julioamerico/blackfin-ip-phone/implementacao/doc/Documento de Requisitos.odt

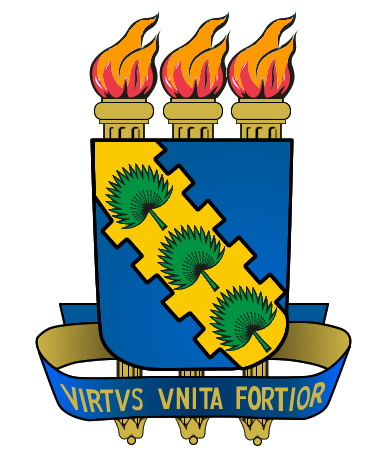
[picture p11: figure]

UNIVERSIDADE FEDERAL DO CEARÁ

CENTRO DE TECNOLOGIA

DEPARTAMENTO DE ENGENHARIA DE TELEINFORMÁTICA

DOCUMENTO DE REQUISITOS

PROJETO: Blackfin IP Phone | DATA: 12/12/2011

# INTRODUÇÃO

O projeto Blackfin IP Phone consiste em um telefone IP com a funcionalidade básica de realizar ligações VoIP. Essa tecnologia compreende um método de comunicação através da fala entre dois locais através de um meio digital de comunicação. A telefonia IP vem sendo abordada há alguns anos o que é motivado pela sua crescente aplicabilidade, bem como a possibilidade de agregação de outras funcionalidades o que a torna um campo de estudo bastante atrativo. A arquitetura de hardware proposta se baseia no processador ADSP-BF518 da família de processadores Blackfin, fabricada pela Analog Devices.

O documento de requisitos se destina a todos os desenvolvedores do projeto Blackfin IP Phone e tem como objetivo principal indicar todos os requisitos funcionais e não-funcionais do projeto, o que auxiliará o seu desenvolvimento através da definição das funcionalidades de hardware, firmware e da aplicação. Este documento é passivo de alterações durante o desenvolvimento, uma vez que poderão ser identificados novos requisitos ou pode ser necessário o detalhamento de alguns requisitos básicos previamente definidos.

# REQUISITOS DO HARDWARE

Esta seção contém todos os requisitos de hardware, com detalhes sobre sua arquitetura, características de processamento, interface com o usuário e descrição dos aspectos mecânicos.

## ARQUITETURA

A arquitetura de hardware é representada através do diagrama de blocos mostrado na Figura 1. Este diagrama de blocos contém as principais interfaces da plataforma de hardware, bem como os barramentos utilizados para comunicação entre os dispositivos e o processador.


Figura 1 - Arquitetura de Hardware

## CARACTERÍSTICAS

Esta seção trata das principais características disponibilizadas pelo hardware, bem como um detalhamento sobre sua capacidade de processamento. De modo geral, o hardware possui as seguintes funcionalidades:

- Memória RAM de 32 MB.
- Memória flash de 4 MB.
- Conexão para cartão de memória microSD.
- Interface de áudio com microfone, speaker e auto-falante.
- Conectividade provida por um módulo WiFi.
- Display LCD gŕafico.
- Botões de navegação e de uso geral.
- Teclado numérico.
- LEDs de uso específico.
- Botão de reset.
- Alimentação a partir de uma bateria de íon de lítio com capacidade de 2000 mAh.

### PROCESSAMENTO

O hardware é baseado no processador ADSP-BF516 da família de processadores Blackfin, do fabricante Analog Devices. Este processador de 32 bits provê os principais barramentos utilizados em aplicações embarcadas, necessários para a interconexão entre dispositivos como LCD, módulo WiFi, memórias e codec de áudio.

### MEMÓRIAS

O processador conta com uma memória SDRAM externa de 32 MB. Para tanto, é utilizada a interface do processador que contém sinais de controle e barramento externo para conexão de memória RAM. A memória SDRAM especificada deve operar a uma frequência de até 133 MHz. Uma memória flash de 4 MB para armazenamento não-volátil é conectada ao processador através de barramento SPI, operando a 100 MHz.

### FONTE

O sistema deve conter uma fonte chaveada de tensão do tipo buck-boost que regulará a tensão proveniente de uma bateria de íon de lítio com capacidade de 2000 mAh, tensão nominal de 3,7 V e dimensões 40 x 65 x 7 mm. A mesma poderá ser recarregada através de um contector micro-USB localizado de modo acessível ao usuário, sem que haja necessidade de abertura do gabinete para seu uso.

## INTERFACE COM O USUÁRIO

A interface com o usuário é contemplada através de botões de navegação, LEDs de uso específico e um display LCD. O gabinete possui características adequadas para essa aplicação, uma vez que provê os rasgos que tornam acessíveis os dispositivos de interface com o usuário. Os conectores de alimentação e de áudio são disponibiveis externamente. Há necessidade de abertura do gabinete somente para a inserção ou remoção do cartão microSD.

O display LCD é do tipo gráfico, com resolução de 160 x 100 pixels, permitindo a visualização de diferentes tipos de tela que permitirão o uso do equipamento para chamada e configuração, por exemplo. Segue abaixo os tipos de tela que o usuário poderá visualizar bem como seu conteúdo.

- Tela de repouso:
  - Data e hora.
  - Nome do telefone (usuário ou empresa).
  - Número do telefone.
  - Quantidade de chamadas perdidas.
- Tela de discagem:
  - Número que está sendo discado.
  - Após o início da chamada, indica que a chamada está em curso.
- Tela de discagem rápida:
  - Lista com um máximo de 10 contatos.
  - Detalhes sobre o contato selecionado.
- Tela de recebimento de chamada:
  - Número do telefone externo.
  - Nome do telefone externo quando o mesmo estiver cadastrado na lista de contatos.
- Tela de estabelecimento de chamada:
  - Após o estabelecimento da chamada discada ou recebida, indica o tempo de chamada.
  - Modo de funcionamento do speaker (on/off).
- Tela de contatos:
  - Lista de contatos cadastrados.
  - Informações do contato selecionado.
- Tela de opções do menu.
  - Histórico de chamadas.
  - Configuração.
  - Informações do sistema.
- Tela de histórico de chamadas:
  - Chamadas efetuadas.
  - Chamadas recebidas.
  - Chamadas perdidas.
- Tela de configuração:
  - Configuração de conta.
    - Nome do telefone (usuário ou empresa).
    - Servidor SIP.
  - Configuração de data e hora.
    - Servidor NTP.
  - Configuração da rede.
    - Habilitação do DHCP (endereço IP dinâmico).
    - Endereço IP.
    - Máscara de rede.
    - Gateway padrão.
    - Tempo de jitter.
  - Configuração da tela de discagem rápida.
  - Configuração de codec de áudio.
    - Lista de codecs suportados.
    - Sequência de prioridade.
- Tela de informações do sistema:
  - Versão do firmware.
  - Atualização de firmware.
  - Teste de conexão com o servidor SIP.
  - Apagar lista de contatos.
  - Restauração da configuração básica do equipamento.

## ASPECTOS MECÂNICOS

O hardware deverá ser encapsulado em um gabinete com dimensões aproximadas 70 x 185 x 25 mm. Este gabinete deverá ter rasgos e furos compatíveis com a aplicação, tornando acessíveis todos os botões, LEDs, display LCD e conectores de alimentação e áudio. Este gabinete deverá ter espaço específico para a acomodação da bateria e um mecanismo adequado para o encaixe das partes que o constituem. Seus encaixes devem proporcionar uma fácil abertura, o que permitirá o acesso ao conector do cartão de memória microSD.

# REQUISITOS DE FIRMWARE

Esta seção contém o conjunto de funcionalidades e características que devem ser promovidas pelo firmware bem como informações sobre os projetos de referência, cujas características foram considerados para definição dos requisitos do projeto Blackfin IP Phone.

## PROJETOS DE REFERÊNCIA

Os projetos de referência são aqueles que farão parte do projeto de modo parcial, provendo módulos já definidos, testados e largamente utilizados em aplicações de mesma natureza. Os projetos de referência utilizados são o U-Boot, o uClinux e o Linphone, que representam um bootloader, um sistema operacional para sistemas embarcados e um projeto de telefone IP, respectivamente, portados para sistemas baseados em processadores Blackfin.

### U-Boot

O bootloader utilizado é o U-Boot, versão 2010r1, disponível no portal Blackfin Koop através do projeto Das U-Boot for the Blackfin Processor. Dentre os diversos processadores suportados por esse bootloader encontra-se o Blackfin.

### uClinux

O uClinux é uma distribuição Linux adaptada para sistemas embarcados. Desse modo, suas bibliotecas são menores e as chamadas ao sistema são semelhantes as do Linux, provendo um sistema estável, confiável e com escalabilidade adequada para sistemas embarcados. Além disso, há um suporte ativo e dinâmico dos projetos envolvendo essa distribuição, fomentado e disponibilizado pelo fabricante Analog Devices no portal Blackfin Koop (blackfin.uclinux.org).

### LINPHONE

O Linphne é o projeto de um telefone IP que foi portado para o uClinux e pode ser executado em plataformas baseadas em processadores da família Blackfin.

## APLICAÇÃO DO PROJETO BLACKFIN IP PHONE

Uma parte dos requisitos da aplicação é baseada nos requisitos dos projetos de referência, o que é determinado pela possibilidade de reuso, reduzindo significativamente o esforço e tempo de projeto. Desse modo, os requisitos elicitados nesta seção consideram arquiteturas, funcionalidades e modos de implementação do uClinux e do projeto Linphone.

Considerando as sete camadas do modelo OSI a estrutura de comunicação entre os clientes é semelhante a representada na Tabela 1.

Tabela 1 – Camadas da estrutura de comunicação

CAMADAS DO MODELO OSI | CAMADAS DA ESTRUTURA DE COMUNICAÇÃO
Camada Física | Wi-Fi
Camada de Enlace | IEEE 802.11
Camada de Rede | Internet
Camada de Transporte | UDP
Camada de Sessão | SIP, RTP
Camada de Apresentação | G.711, G.722, G.723, G.726, G.729, Speex
Camada de Aplicação | Aplicação do Projeto Blackfin IP Phone

Esta seção contém os requisitos de firmware relacionados a aplicação, onde são definidos, dentre outros, os protocolos que deverão ser suportados para estabelecimento da conexão com o servidor, os métodos de codificação e decodificação do áudio e as características de armazenamento de dados. Assim, nesta seção serão apresentadas as principais protocolos e padrões suportados, funcionalidades e requisitos de firmware do projeto.

### CODECS DE ÁUDIO

Os codecs de áudio são padrões de codificação e decodificação do sinal de áudio. Sua função é transformar o sinal de áudio analógico em informação digital que irá trafegar na rede, e vice-versa. Para permitir a compatibilidade de codecs entre os usuários em uma aplicação VoIP, é necessário que seja feito uma lista de prioridade de codecs, a partir da qual haverá a checagem de compatilidade com o usuário destino. Caso nenhum dos codecs da lista de prioridades seja aceito pelo usuário destino, então a chamada não será estabelecida. Os codecs de áudio suportados devem ser os mesmos utilizados no projeto Linphone. São eles:

- G.711
- G.722
- G.723
- G.726
- G.729
- Speex

### CONFIGURAÇÃO DE REDE

Em todos os cenários de funcionamento do equipamento deverá ser verificado o gerenciamento da comunicação entre os dispositivos através de um servidor SIP. A seguir são detalhados os modos de aquisição de parâmetros de rede (endereço IP, máscara de rede, gateway) a partir dos quais o servidor estabelecerá a comunicação entre usuários.

#### 4.2.2.1. SERVIDOR SIP

O protocolo de controle de sessão a ser utilizado é o SIP. Este protocolo será utilizado para configuração das sessões através da rede, estabelecendo a localização dos clientes, inicialização e término de sessões.

O usuário deverá ser capaz de registrar o servidor SIP a partir do qual as chamadas serão gerenciadas. Para tanto, o usuário deverá declarar o endereço IP do servidor e a porta utilizada.

#### 4.2.2.2. SERVIDOR DHCP

Quando conectado a um servidor DHCP, os parâmetros de rede serão atribuídos ao equipamento de forma dinâmica. Desse modo, quando o usuário habilitar a conexão do equipamento a um servidor DHCP não deverá ser possível fazer a configuração dos parâmetros de rede manualmente.

### ARMAZENAMENTO DE INFORMAÇÕES

O sistema deverá ser capaz de armazenar informações em sua memória. O espaço alocado para o armazenamento deverá ser definido em tempo de projeto. A Tabela 2 indica os tipos de informações que devem ser armazenadas e seus respectivos dispositivos de armazenamento.

Tabela 2 – Informações a serem armazenadas

TIPO DE INFORMAÇÃO | DISPOSITIVO DE ARMAZENAMENTO
Lista de contatos | Cartão de memória microSD
Lista de discagem rápida | Cartão de memória microSD
Histórico de chamadas | Cartão de memória microSD
Informações do equipamento | Memória flash
Configuração atual do equipamento | Memória flash
Configuração de restauração do equipamento | Memória flash

### CONFIGURAÇÃO DE DATA E HORA

A definição de data e hora deverá ser feita somente de modo automático através da configuração de um servidor NTP. Portanto, o usuário deverá ser capaz de inserir o endereço do servidor NTP responsável pelo ajuste de tempo do equipamento.

A configuração do servidor NTP é opcional. Caso esta configuração não seja realizada, o equipmanento não apresentará informações de data e hora. Caso a conexão entre o equipamento e um servidor DHCP esteja habilitada, a solicitação do endereço do servidor NTP pode ser feita de modo automático. Caso o servidor DHCP responda a esta solicitação, então os parâmetros do servidor NTP deverão ser sobrescritos.

### ATUALIZAÇÃO DO FIRMWARE

Deve ser disponibilizada uma opção de atualização de firmware do equipamento. Esse tipo de atualização tem por objetivo corrigir erros de implementação, agregar ou melhorar as funcionalidades do equipamento.

A atualização de firmware se dá pelo download de uma nova imagem do firmware através de um servidor TFTP. Para tanto, o usuário deverá ser capaz de inserir o endereço do servidor TFTP para as operações de atualização do sistema.

A configuração do servidor TFTP é opcional. Caso esta configuração não seja realizada, o equipmanento não estará habilitado a fazer atualizações de firmware. Caso a conexão entre o equipamento e um servidor DHCP esteja habilitada, a solicitação do endereço do servidor TFTP pode ser feita de modo automático. Caso o servidor DHCP responda a esta solicitação, os parâmetros do servidor TFTP deverão ser sobrescritos.

### RESTAURAÇÃO DO SISTEMA

Na tela de informações do sistema deve haver uma opção para restauração do sistema, onde valores padrão para as configurações são atribuídos, sobrescrevendo os valores atuais. Dentre as informações gravadas nos dispositivos de armazenamento, somente aquelas relacionadas a configuração atual do equipamento deverão ser alteradas. Portanto, informações como lista de contatos, lista de discagem rápida, perfil de configuração de restauração, histórico de chamadas e informações do equipamento não deverão ser apagadas.

# AMBIENTE DE DESENVOLVIMENTO

Esta seção contém todos os detalhes relacionados a configuração das estações de trabalho, softwares e ferramentas utilizadas no desenvolvimento do projeto.

## ESTAÇÕES DE TRABALHO

O desenvolvimento de firmware deve ser realizado em sua totalidade em ambiente Linux, distribuição Ubuntu, versão do Kernel 2.6.35. O desenvolvimento de hardware deverá ser realizado utilizando o sistema operacional Windows 7.

## FERRAMENTAS DE DESENVOLVIMENTO DO FIRMWARE

As ferramentas de desenvolvimento do firmware encontram-se encapsuladas em um módulo dependente da plataforma alvo e denotado por toolchain. O toolchain do Blackfin consiste de um conjunto de utilitários necessários para a compilação, depuração e geração de programas executáveis a partir do código fonte dos artefatos de firmware como bootloader e kernel do uClinux, por exemplo. O toolchain utilizado é disponibilizado pelo potal Blackfin Koop. Para download e instalação do toolchain, ver o Relatório de Firmware.

## FERRAMENTAS DE DESENVOLVIMENTO DO HARDWARE

O desenvolvimento dos esquemas elétricos e layout do projeto Blackfin IP Phone deve ser realizado utilizando o software Altium Designer 10, uma ferramenta EDA (Electronic Design Automation) utilizada para realizar o projeto elétrico e mecânico de equipamentos eletrônicos. Esse software provê de modo centralizado todas as ferramentas necessárias para o desenvolvimento do hardware até a sua efetiva fabricação.
