julioamerico/blackfin-ip-phone/pesquisa/bateria/Li-Polymer_battery_quotation_-_3.7V_2000mAh.xls

 |  | HOLY TECHNOLOGY CO.,LTD
 |  | Address: Room 301, Buliding 2,Lane 5,Bantian Dongcun, Longgang District, Shen Zhen ,China,518129
 |  | Mobile:13652391374 E-mail: info@holyrich.com
Quotation Sheet
Attn: |  | Rômulo Mendes
Date: |  | 24th,September, 2011
Subject: |  | Li-Polymer PC-714065 3.7V 2000mAh battery
 |  |  |  |  | Unit price (USD/pc)
Model | Type | Dimension (mm) | Weight (g) | Discription |  | 5pcs | 1000pcs
PC-714065 | Li-ion | 7.1*40*65mm | About 38g | Li-Polymer battery PL714065, 3.7V 2000mAh cell |  | 3.51 | 3.05
Remark:
1.Price Term: FOB Shenzhen
2.Payment: 100% by T/T transfer to our bank account for order confirmation, balance before shipment;
3.Lead time: 3-4 weeks after order confirmation;
4.Warranty:one year for sale after;
5.The above price will be valid within 60 days, and it is based on the above data in the table, for the special items, the price will be quotated sperately,
