julioamerico/blackfin-ip-phone/implementacao/hw/bom/ip_phone.xls

 | Lista de Materiais
 | Universidade Federal do Ceará |  | Projeto: | Blackfin IP Phone | 1 Placa ($): | 164.84
 | Centro de Tecnologia |  | Documento gerado em: | 2012-01-24 | 1000 Placas ($) | 112.85
 | Dep. de Engenharia de Teleinformática |  |  |  | Itens por Placa | 324
# | Part# | Comment | Footprint | Manufacturer | Designator | eVendorPart# | Quantity | MSRP | Total MSRP | eVendor | eVendorPrice | Total Vendor | MOQ
1 | ANT040015CCS2442MA1 | Chip_Antenna_2.4GHz | ANTENNA | TDK | ANT500 | 445-6134-1-ND | 1 | 3,15 | 3.15 | Digikey | 5,94 | 5.94 | 1000
2 | PC-714065 | Battery |  | HOLY TECHNOLOGY | B600 | PC-714065 | 1 | 3,05 | 3.05 | HOLY TECHNOLOGY | 3,51 | 3.51 | 1000
3 | C1005X7R1C103KT | 10nF | CC1005-0402 | TDK | C100, C102, C103, C104, C105, C106, C107, C108, C509, C619, C620, C621, C622, C623, C624, C629, C630, C631, C632, C633, C634, C642, C643, C644, C645, C646, C647, C648 | 810-C1005X7R1C103K | 28 | 0,004 | 0.11 | Mouser | 0,03 | 0.84 | 1000
4 | CC0402KRX7R9BB221 | 220pF | CC1005-0402 | Yageo | C101, C309 | 311-1035-1-ND | 2 | 0,00335 | 0.01 | Digikey | 0,015 | 0.03 | 1000
5 | GRM1555C1H220JZ01D | 22pF | CC1005-0402 | Murata Electronics North America | C109, C110 | 490-1283-1-ND | 2 | 0,00614 | 0.01 | Digikey | 0,028 | 0.06 | 1000
6 | C1005X7R1C104KT | 100nF | CC1005-0402 | TDK | C200, C201, C202, C300, C314, C315, C405, C501, C503, C504, C507, C508, C603, C611, C615, C616, C617, C618, C627, C628, C638, C639, C640, C641, C650, C653, C654, C655, C656 | 810-C1005X7R1C104K | 29 | 0,005 | 0.14 | Mouser | 0,03 | 0.87 | 1000
7 | CC0402KRX7R6BB473 | 47nF | CC1005-0402 | Yageo | C301 | 311-1334-1-ND | 1 | 0,00429 | 0.00429 | Digikey | 0,02 | 0.02 | 1000
8 | CC0402KRX7R7BB102 | 1nF | CC1005-0402 | Yageo | C302 | 311-1352-1-ND | 1 | 0,00335 | 0.00335 | Digikey | 0,015 | 0.01 | 1000
9 | VE-100M0JTR-0305 | 10uF | VE-100M0JTR-0305 | Lelon | C303 | 140-VE100M0JTR0305 | 1 | 0,099 | 0.10 | Mouser | 0,18 | 0.18 | 1000
10 | C1005X5R0J475MT | 4,7uF | CC1005-0402 | TDK | C304, C307, C310, C311, C312, C313, C500, C502 | 810-C1005X5R0J475M | 8 | 0,108 | 0.86 | Mouser | 0,22 | 1.76 | 1000
11 | GRM155R60J105ME19D | 1uF | CC1005-0402 | Murata Electronics North America | C305, C306, C400, C401, C402, C403, C404, C610, C649, C651 | 490-1319-1-ND | 10 | 0,01193 | 0.12 | Digikey | 0,055 | 0.55 | 1000
12 | T491D227K006AT | 220uF |  | Kemet | C308 | 80-T491D227K006 | 1 | 0,44 | 0.44 | Mouser | 1,28 | 1.28 | 1000
13 | C1005C0G1H121JT | 120pF | CC1005-0402_NP | TDK | C505 | 810-C1005C0G1H121J | 1 | 0,007 | 0.01 | Mouser | 0,03 | 0.03 | 1000
14 | GRM1535C1HR30BDD5D | 0,3pF | CC1005-0402 | Murata | C506 | 81-GRM1535C1HR30BD5D | 1 | 0,012 | 0.01 | Mouser | 0,15 | 0.15 | 1000
15 | C2012Y5V1A106ZT | 10uF | CC1608-0603 | TDK | C600, C601, C602, C604, C605, C613, C614, C625, C626, C635, C636, C637, C652 | 810-C2012Y5V1A106Z | 13 | 0,033 | 0.43 | Mouser | 0,14 | 1.82 | 1000
16 | GRM188F51A225ZE01D | 2,2uF | CC1608-0603 | Murata | C612 | 81-GRM188F51A225ZE01 | 1 | 0,04 | 0.04 | Mouser | 0,17 | 0.17 | 1000
17 | 045138008010890+ | MicroSD | MICRO_SD | AVX Corporation | CON200 | 478-4965-1-ND | 1 | 2,394 | 2.39 | Digikey | 3,86 | 3.86 | 1000
18 | SJ1-2535-SMT | Phone_Jack | Phone_Jack | CUI Inc | CON300, CON301 | CP1-2535SJCT-ND | 2 | 0,415 | 0.83 | Digikey | 0,75 | 1.50 | 1000
19 | IL-Z-C3-A-1-15000 | Crimp |  | JAE Electronics | CR300, CR301, CR302, CR303, CR304, CR305 | 656-ILZC3A115000 | 6 | 0,049 | 0.29 | Mouser | 0,05 | 0.30 | 1000
20 | APT1608SURCK | RED | LED_0603 | Kingbright | D200 | 604-APT1608SURCK | 1 | 0,06 | 0.06 | Mouser | 0,16 | 0.16 | 1000
21 | TLHR4205 | RED | LED 3MM VERMELHO PF-D3 | Vishay Semiconductors | D201, D600 | 78-TLHR4205 | 2 | 0,065 | 0.13 | Mouser | 0,11 | 0.22 | 1000
22 | TLHY4205 | YELLOW | LED 3MM AMARELO PF-D3 | Vishay Semiconductors | D202 | 78-TLHY4205 | 1 | 0,082 | 0.08 | Mouser | 0,13 | 0.13 | 1000
23 | TLHG4205 | GREEN | LED 3MM VERDE PF-D3 | Vishay Semiconductors | D203 | 78-TLHG4205 | 1 | 0,064 | 0.06 | Mouser | 0,10 | 0.10 | 1000
24 | SAM8218-ND | Flat Cable |  | Samtec | FC200 | SAM8218-ND | 1 | 6,20 | 6.20 | Digikey | 10,76 | 10.76 | 1000
25 | GRPB052VWQS-RC | CONN HEADER | CON_JTAG | Sullins | J200 | S9012E-05-ND | 1 | 0,47 | 0.47 | Digikey | 0,95 | 0.95 | 1000
26 | GRPB101VWVN-RC | CONN HEADER | CONECTOR_10_PIN | Sullins Connector Solutions | J201, J202, J302 | S9014E-10-ND | 3 | 0,32775 | 0.98 | Digikey | 0,66 | 1.98 | 1000
27 | IL-Z-2PL-SMTYE | Speaker | CON_IL-Z-2PL | JAE Electronics | J300, J301 | 656-IL-Z-2PL-SMTYE | 2 | 0,22 | 0.44 | Mouser | 0,33 | 0.66 | 1000
28 | 52892-1495 | LCD Connector | LCD_Connector | Molex | J400 | 538-52892-1495 | 1 | 0,45 | 0.45 | Mouser | 1,27 | 1.27 | 1000
29 | 10103594-0001LF | Micro USB B | Micro USB | FCI | J600 | 649-10103594-0001LF | 1 | 0,306 | 0.31 | Mouser | 0,45 | 0.45 | 1000
30 | EXC-3BP600H | FB 60 Ohm @100MHz | INDUTOR_0603 | Panasonic Electronic Components | L300 | 667-EXC-3BP600H | 1 | 0,066 | 0.07 | Mouser | 0,11 | 0.11 | 1000
31 | L-07C3N0SV6T | 3nH | INDUTOR_0402 | Johanson Technology Inc | L500 | 712-1457-1-ND | 1 | 0,225 | 0.23 | Digikey | 0,04 | 0.04 | 1000
32 | VLF4012AT-2R2M1R5 | 2,2uH | POWER INDUCTOR | TDK | L600 | 445-3233-1-ND | 1 | 0,495 | 0.49 | Digikey | 0,77 | 0.77 | 500
33 | BLM18PG300SN1D | Ferrite Bead 30 Ohm | INDUTOR_0603 | Murata | L602 | 81-BLM11P300S | 1 | 0,041 | 0.04 | Mouser | 0,19 | 0.19 | 1000
34 | NHD-C160100DiZ-FSW-FBW | NHD-C160100DiZ-FSW-FBW |  | Newhaven Display | LCD400 | 763-C160100DIZFSWFBW | 1 | 15,39 | 15.39 | Mouser | 18,55 | 18.55 | 50
35 | POM-2738P-C33-R | MIC | CON_IL-Z-2PL | PUI Audio | M300 | 665-POM2738PC33R | 1 | 1,13 | 1.13 | Mouser | 1,98 | 1.98 | 500
36 | IL-Z-2S-S125C3 | Socket Housing |  | JAE Electronics | P300, P301, P302 | 656-IL-Z-2S-S125C3 | 3 | 0,042 | 0.13 | Mouser | 0,11 | 0.33 | 1000
37 | SM02B-SRSS-TB(LF)(SN) | Header 2x1 | HEADER 2X1 | JST Sales America Inc | P400 | 455-1802-1-ND | 1 | 0,23142 | 0.23 | Digikey | 0,38 | 0.38 | 500
38 | S3B-XH-SM4-TB(LF)(SN) | Header 3x1 | HEADER 3x1 | JST Sales America Inc | P600 | 455-2263-1-ND | 1 | 0,5125 | 0.51 | Digikey | 0,67 | 0.67 | 100
39 | CRCW040222R0JNED | 22R | CR1005-0402 | Vishay/Dale | R100, R101, R102, R103, R104, R105, R106, R107, R108, R109, R110, R111, R112, R113, R114, R115, R116, R117, R118, R119, R120, R121, R122, R123, R124, R125, R126, R127, R128, R129, R130, R131, R132, R134, R136, R138, R140, R141, R142, R308, R309, R311, R312, R326 | 71-CRCW0402J-22-E3 | 44 | 0,015 | 0.66 | Mouser | 0,08 | 3.52 | 1000
40 | RC0402JR-0710KL | 10K | CR1005-0402, CR1005-0402_NP | Yageo | R133, R135, R144, R146, R201, R219, R220, R221, R222, R223, R224, R225, R226, R227, R228, R229, R230, R303, R306, R400, R402, R412, R502, R503, R504, R505, R506, R507, R508, R509, R510, R511, R512, R513, R515, R516, R517, R518, R519, R520, R521, R522, R523, R524, R607, R608, R614 | 311-10KJRCT-ND | 47 | 0,00253 | 0.12 | Digikey | 0,012 | 0.56 | 1000
41 | RC0402JR-07100KL | 100K | CR1005-0402 | Yageo | R137, R310, R316 | 311-100KJRCT-ND | 3 | 0,00253 | 0.01 | Digikey | 0,012 | 0.04 | 1000
42 | RC0402JR-0733RL | 33R | CR1005-0402 | Yageo | R139, R237, R238 | 311-33JRCT-ND | 3 | 0,00253 | 0.01 | Digikey | 0,012 | 0.04 | 1000
43 | RC0402JR-0733KL | 33K | CR1005-0402 | Yageo | R143 | 311-33KJRCT-ND | 1 | 0,00253 | 0.00253 | Digikey | 0,012 | 0.01 | 1000
44 | RMCF0402JT10M0 | 10M | CR1005-0402 | Stackpole Electronics Inc | R145 | RMCF0402JT10M0CT-ND | 1 | 0,00256 | 0.00256 | Digikey | 0,02 | 0.02 | 1000
45 | CR0603-JW-101GLF | 100R | CR1608-0603 | Bourns | R200, R210, R211, R212, R602 | 652-CR0603-JW-101GLF | 5 | 0,01 | 0.05 | Mouser | 0,06 | 0.30 | 1000
46 | ERJ-2GE0R00X | 0R | CR1005-0402 | Panasonic Electronic Components | R202, R204, R205, R208, R209, R215, R218, R231, R232, R233, R234, R235, R236, R313, R317, R319, R320, R321, R322, R323, R324, R325, R327, R328, R329, R330, R331, R332, R333, R401, R403, R404, R405, R406, R407, R408, R409, R410, R411, R500, R525 | 667-ERJ-2GE0R00X | 41 | 0,004 | 0.16 | Mouser | 0,05 | 2.05 | 1000
47 | RC0402JR-071K2L | 1K2 | CR1005-0402 | Yageo | R206, R207, R314, R606 | 311-1.2KJRCT-ND | 4 | 0,00253 | 0.01 | Digikey | 0,012 | 0.05 | 1000
48 | CRCW040249R9FKED | 49R9 | CR1005-0402_NP | Vishay/Dale | R214, R216, R217 | 71-CRCW0402-49.9-E3 | 3 | 0,015 | 0.04 | Mouser | 0,07 | 0.21 | 1000
49 | RC0402JR-072K2L | 2K2 | CR1005-0402 | Yageo | R304 | 311-2.2KJRCT-ND | 1 | 0,00253 | 0.00253 | Digikey | 0,012 | 0.01 | 1000
50 | RMCF0402FT330K | 330K | CR1005-0402 | Stackpole Electronics Inc | R315 | RMCF0402FT330KCT-ND | 1 | 0,00384 | 0.00384 | Digikey | 0,04 | 0.04 | 1000
51 | RC0402JR-0747KL | 47K | CR1005-0402 | Yageo | R318 | 311-47KJRCT-ND | 1 | 0,00253 | 0.00253 | Digikey | 0,012 | 0.01 | 1000
52 | 304-200K-RC | 200K | CR1005-0402 | Xicon | R501, R514 | 304-200K-RC | 2 | 0,016 | 0.03 | Mouser | 0,04 | 0.08 | 1000
53 | CR0603-JW-152GLF | 1K5 | CR1608-0603 | Bourns | R600 | 52-CR0603-JW-152GLF | 1 | 0,008 | 0.01 | Mouser | 0,02 | 0.02 | 1000
54 | RK73Z2ETTD | 0R | CR3225-1210 | KOA Speer | R601, R611 | 660-RK73Z2ETTD | 2 | 0,08 | 0.16 | Mouser | 0,14 | 0.28 | 1000
55 | CR0603-J/-000ELF | 0R | CR1608-0603 | Bourns | R603, R604, R612 | 652-CR0603-J/-000ELF | 3 | 0,008 | 0.02 | Mouser | 0,02 | 0.06 | 1000
56 | RC0402JR-07680RL | 680R | CR1005-0402 | Yageo | R605 | 311-680JRCT-ND | 1 | 0,00253 | 0.00253 | Digikey | 0,012 | 0.01 | 1000
57 | ERJ-2RKF2052X | 20K5 | CR1005-0402 | Panasonic - ECG | R613 | P20.5KLCT-ND | 1 | 0,00672 | 0.01 | Digikey | 0,06 | 0.06 | 1000
58 | ERJ-2RKF2553X | 255K | CR1005-0402 | Panasonic - ECG | R615 | P255KLCT-ND | 1 | 0,00672 | 0.01 | Digikey | 0,06 | 0.06 | 1000
59 | 254-DS238-RO | 8 Ohms/1W |  | Kobitone | S300 | 254-DS238-RO | 1 | 1,32 | 1.32 | Mouser | 2,25 | 2.25 | 1000
60 | 254-DR132-RO | 32 Ohms/26mW |  | Kobitone | S301 | 254-DR132-RO | 1 | 1,52 | 1.52 | Mouser | 1,98 | 1.98 | 1000
61 | PTS525SM10SMTR LFS | SW | PUSH-PTS525 | C&K Components | SW200, SW201 | 611-PTS525SM10-LFS | 2 | 0,244 | 0.49 | Mouser | 0,48 | 0.96 | 1000
62 | ADSP-BF516KBCZ-4F4 | ADSP-BF516KBCZ-4F4 | BGA168 | Analog Device | U100 | ADSP-BF516KBCZ-4F4 | 1 | 14,15 | 14.15 | Avnet | 19,42 | 19.42 | 500
63 | MT48LC16M16A2BG-75 IT:D | MT48LC16M16A2BG-75 | VFBGA54 | Micron | U101 | MT48LC16M16A2BG-75 IT:D | 1 | 8,33 | 8.33 | Avnet | 9,23 | 9.23 | 100
64 | CAT811STBI-GT3 | CAT811S | SOT-143 | ON Semiconductor | U200 | 698-CAT811STBI-GT3 | 1 | 0,156 | 0.16 | Mouser | 0,22 | 0.22 | 1000
65 | S25FL064P0XNFI000 | S25FL064P0XNFI000 | WSON8 | Spansion | U202 | S25FL064P0XNFI000 | 1 | 1,88 | 1.88 | Avnet | 1,99 | 1.99 | 100
66 | FSA2259UMX | FSA2259 | QFN-10FSA | Fairchild Semiconductor | U300 | 512-FSA2259UMX | 1 | 0,22 | 0.22 | Mouser | 0,68 | 0.68 | 1000
67 | WM8940GEFL/V | WM8940 | QFN24 | Wolfson Microelectronics | U301 | 238-WM8940GEFL/V | 1 | 1,70 | 1.70 | Mouser | 2,82 | 2.82 | 1000
68 | 74LVC1G384GV,125 | 74LVC1G384 | SOT753 | NXP Semiconductors | U302 | 771-LVC1G384GV125 | 1 | 0,046 | 0.05 | Mouser | 0,07 | 0.07 | 1000
69 | ADP5587ACPZ-R7 | ADP5587 | QFN-24 | Analog Devices | U400 | ADP5587ACPZ-R7CT-ND | 1 | 1,725 | 1.73 | Digikey | 3,45 | 3.45 | 1000
70 | NVT2006PW,118 | NVT2006PW118 | TSSOP16 | NXP Semiconductors | U500, U502 | 771-NVT2006PW118 | 2 | 0,375 | 0.75 | Mouser | 0,76 | 1.52 | 1000
71 | 450-0037 | TiWi01-R2 | WIFI_MODULE | LS Research | U501 | 741-450-0037 | 1 | 30,80 | 30.80 | Mouser | 32,55 | 32.55 | 100
72 | TPS63001DRCR | TPS63001DRCR | SON10 | Texas Instruments | U600 | 296-19643-1-ND | 1 | 2,25 | 2.25 | Digikey | 4,5 | 4.50 | 1000
73 | BQ24090DGQT | BQ24090 | MSOP10 | Texas Instruments | U601 | 595-BQ24090DGQT | 1 | 1,16 | 1.16 | Mouser | 2,76 | 2.76 | 1000
74 | AME8800DEETZ | AME8800DEETZ | SOT-23 | AME | U604 | 827-AME8800DEETZ | 1 | 0,171 | 0.17 | Mouser | 0,67 | 0.67 | 1000
75 | NCP1117ST18T3G | NCP1117ST18T3G | SOT223 | ON Semiconductor | U605 | 863-NCP1117ST18T3G | 1 | 0,171 | 0.17 | Mouser | 0,35 | 0.35 | 1000
76 | TPS73601DCQR | TPS73601 | SOT223 - 6P | Texas Instruments | U606 | 595-TPS73601DCQR | 1 | 1,17 | 1.17 | Mouser | 2,25 | 2.25 | 1000
77 | MC-306 32.7680K-A0:ROHS | 32.768KHz | XTAL_32.768kHz | Epson | X100 | 732-MC30632.7680KA0R | 1 | 0,378 | 0.38 | Mouser | 0,95 | 0.95 | 1000
78 | ASFL1-25.000MHZ-EC-T | 25MHz | OSC_25MHz | ABRACON | Y100 | 300-8254-1-ND | 1 | 1,292 | 1.29 | Digikey | 2,55 | 2.55 | 1000
79 | ASEK2-32.768KHz-LRT | 32,768K | OSCILLATOR_32K | Abracon | Y500 | 815-ASEK2-32.7K-LRT | 1 | 2,44 | 2.44 | Mouser | 3,66 | 3.66 | 500
