julioamerico/blackfin-ip-phone/implementacao/hw/prj/ip_phone.pdf

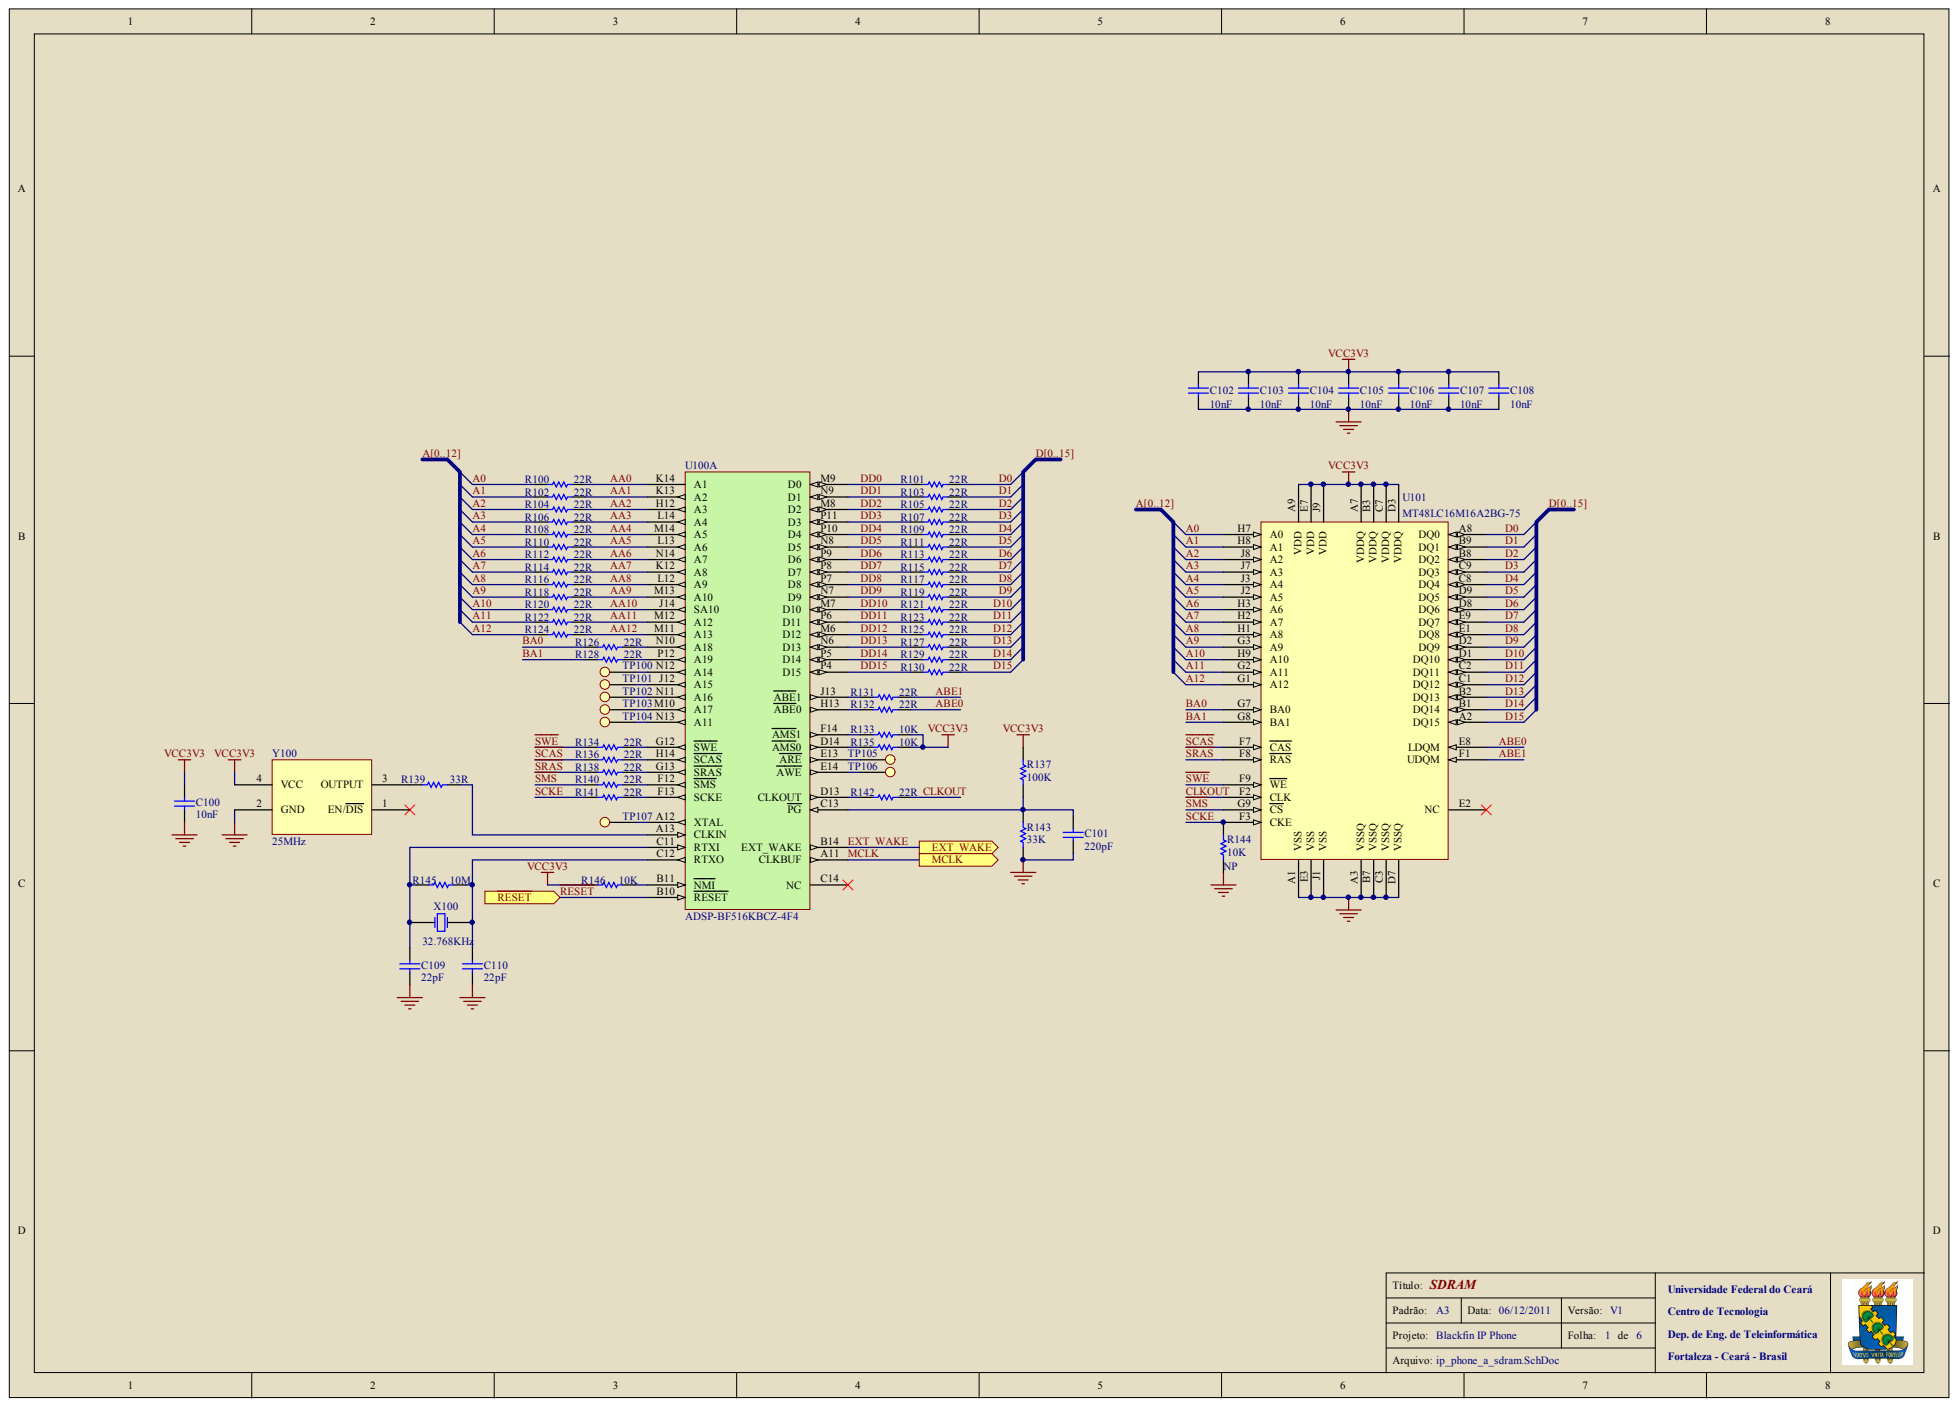
[picture p12: page 1]

SCAS SRAS SMS SCKE

VCC3 V 3

RTXO C12 | 1 MCL K

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

P r oj e t o : Bl a c kfi n I P P h o n e | | F o l h a : d e

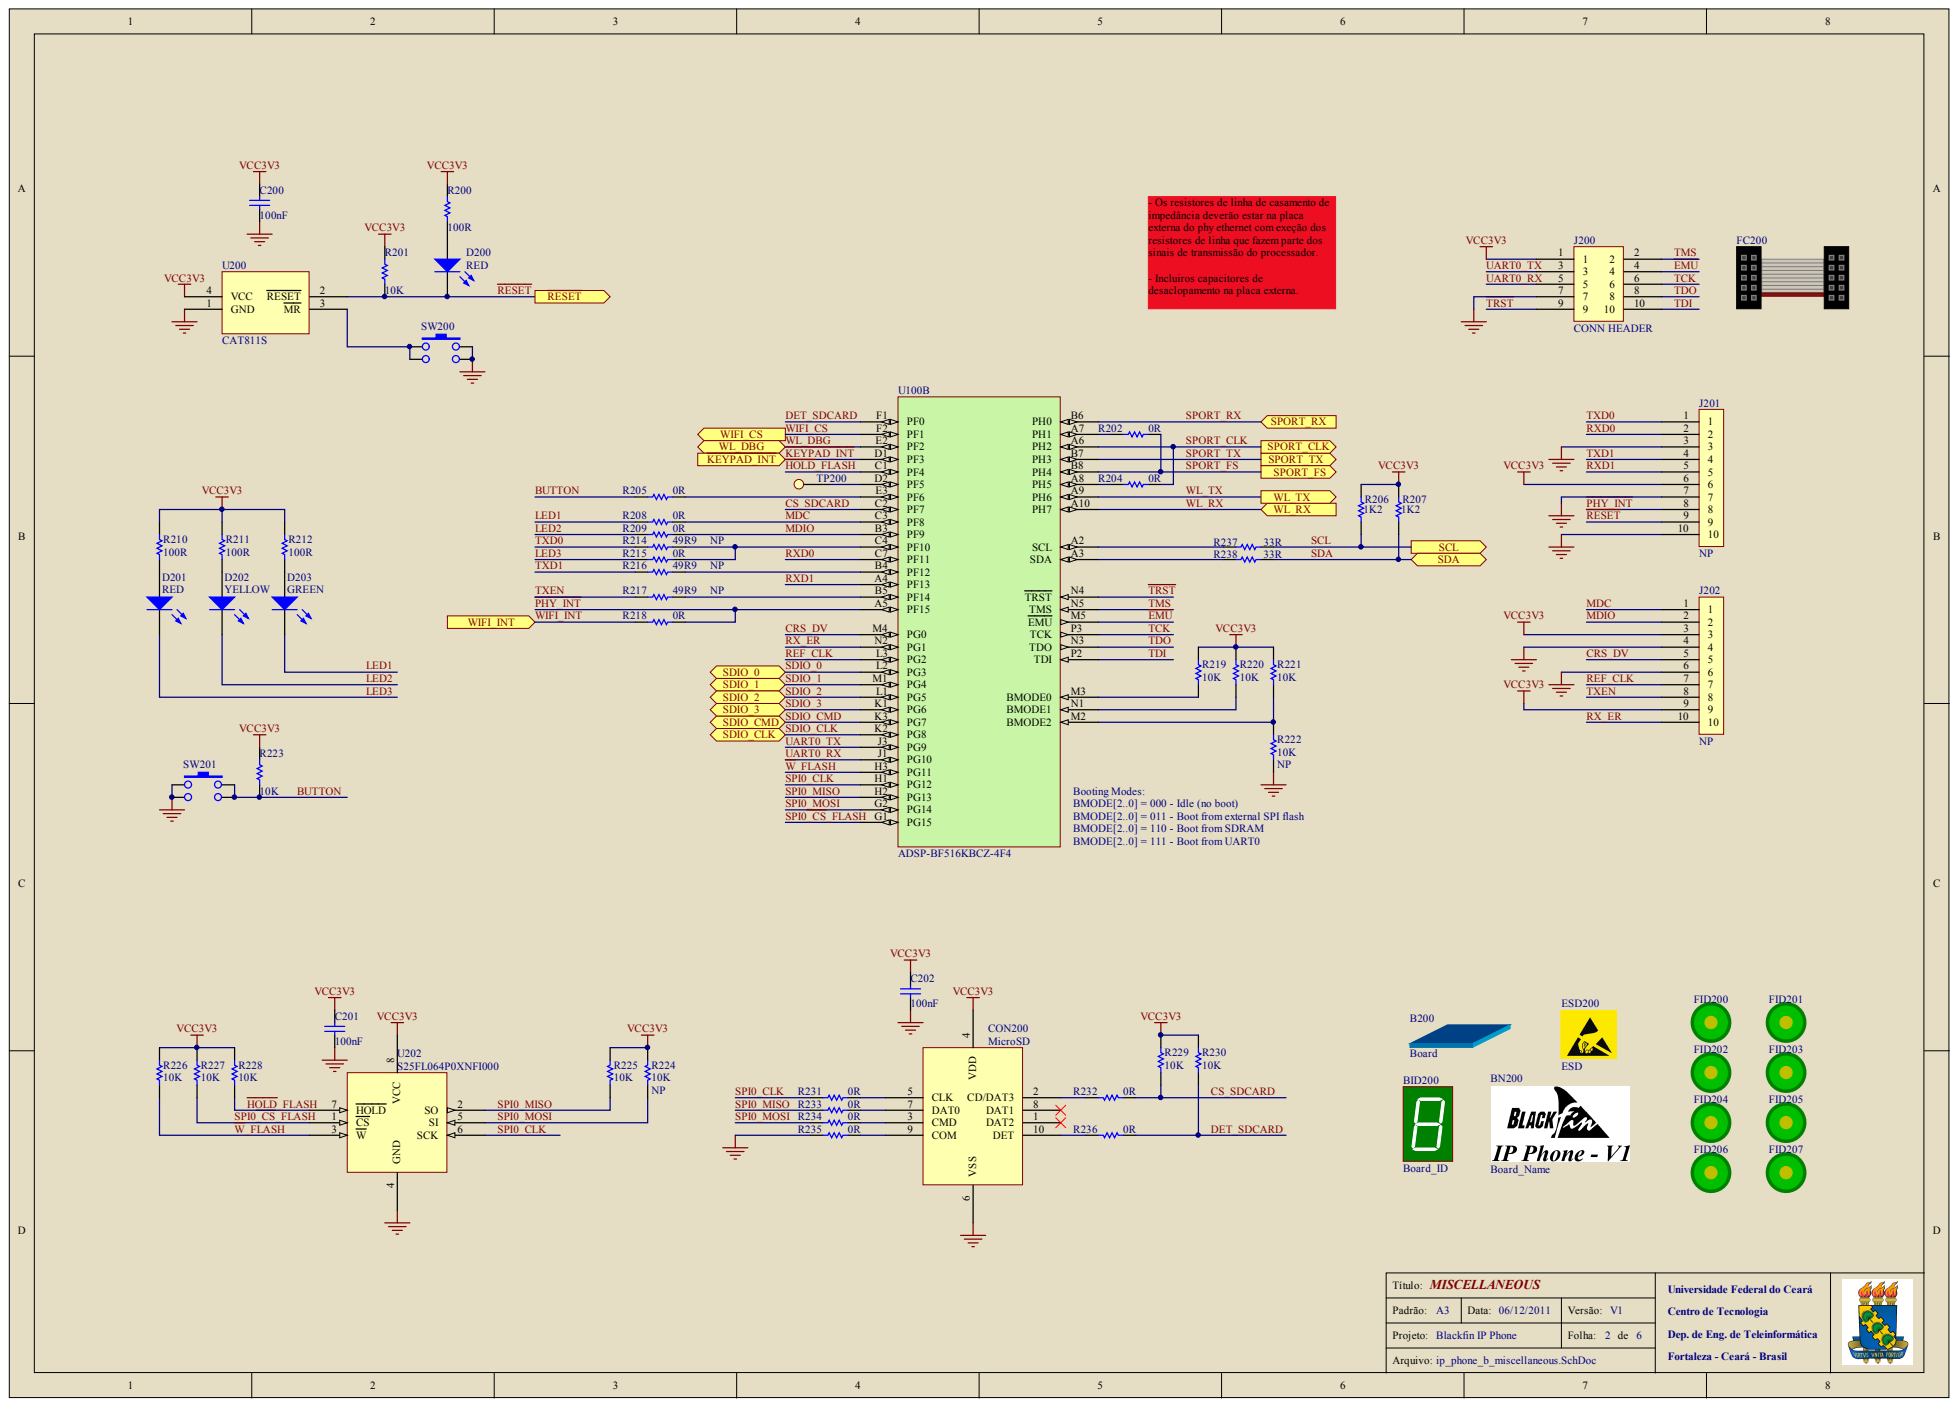
[picture p13: page 2]

- Os resistores de linha de casamento de
impedância deverão estar na placa
externa do phy ethernet com exeção dos
resistores de linha que fazem parte dos
sinais de transmissão do processador.

- Incluiros capacitores de
desaclopamento na placa externa.

Booting Modes:
BMODE[2..0] = 000 - Idle (no boot)
BMODE[2..0] = 011 - Boot from external SPI flash
BMODE[2..0] = 110 - Boot from SDRAM
BMODE[2..0] = 111 - Boot from UART0

Título: MISCELLANEOUS | Universidade Federal do Ceará Centro de Tecnologia Dep. de Eng. de Teleinformática Fortaleza - Ceará - Brasil

Padrão: | Data: 06/12/2011 | Versão: V1

Projeto: Blackfin IP Phone | | Folha: de

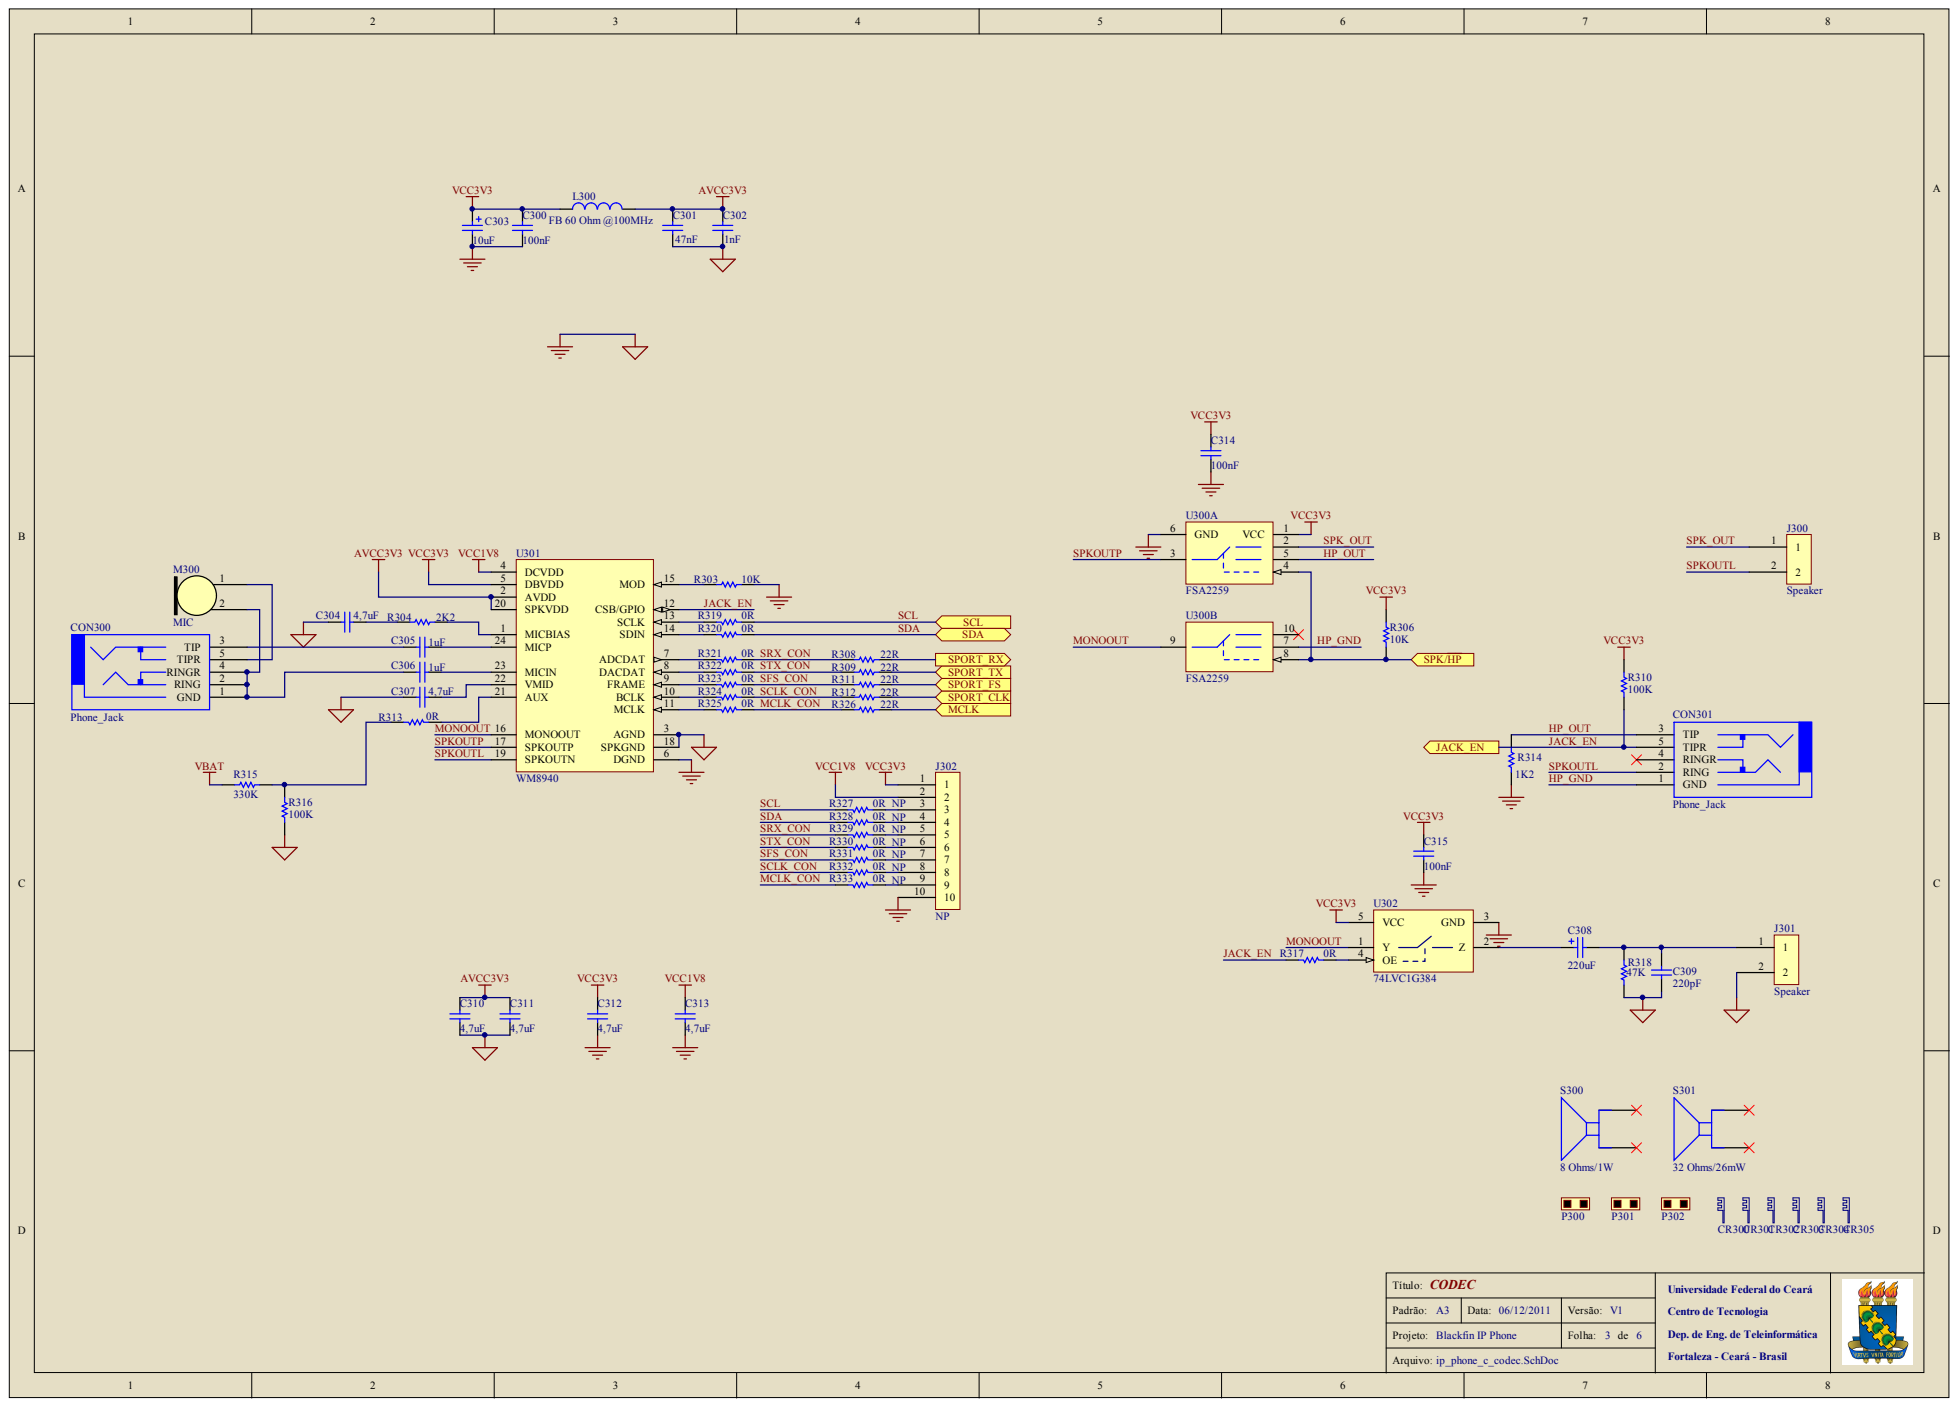
[picture p14: page 3]

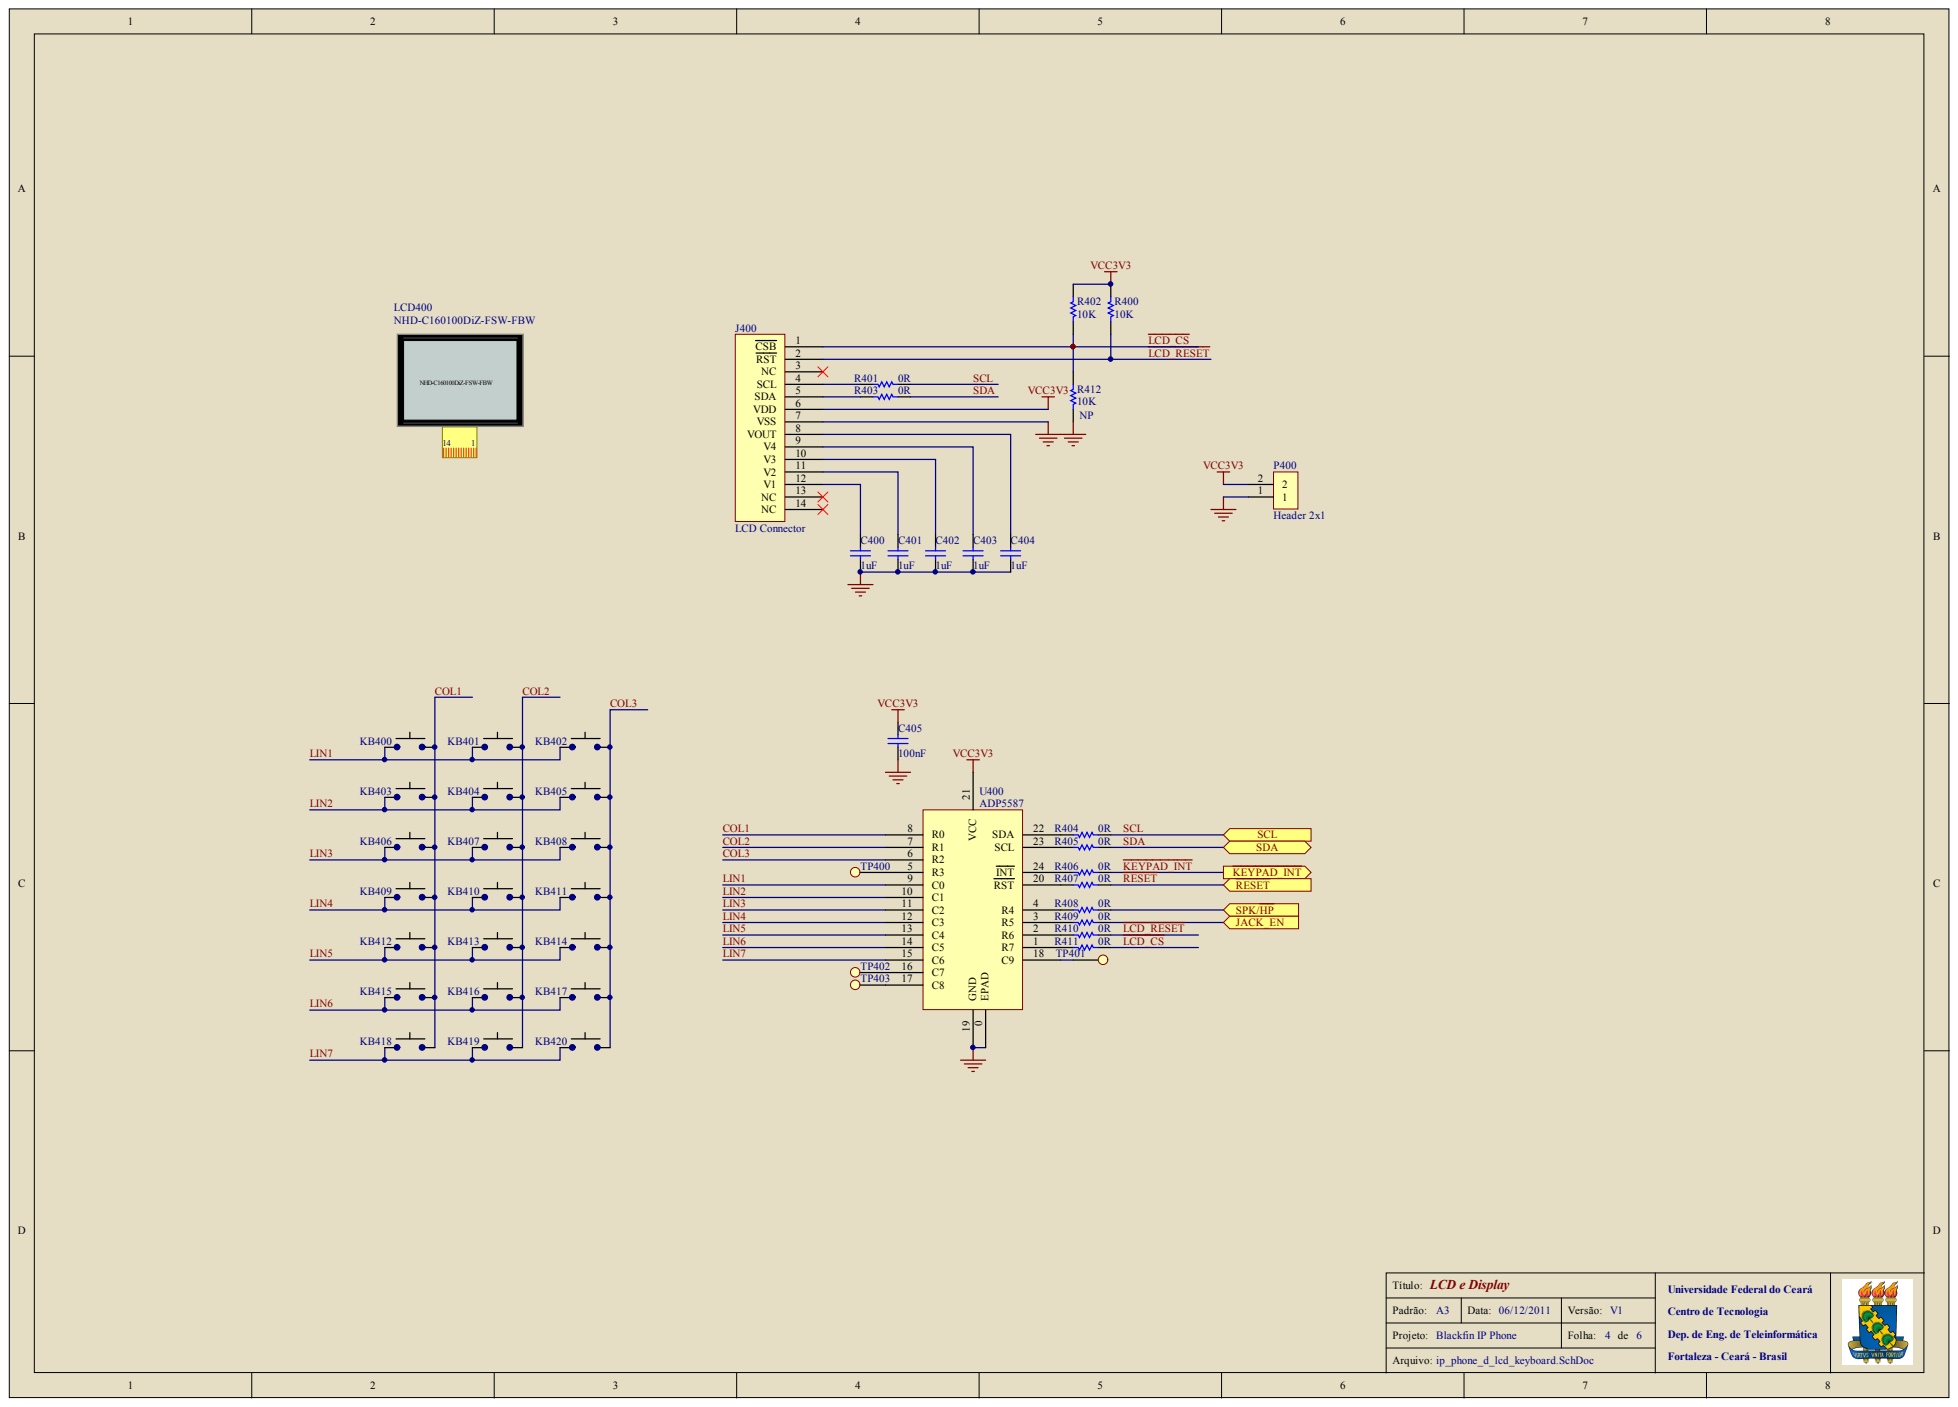
[picture p15: page 4]

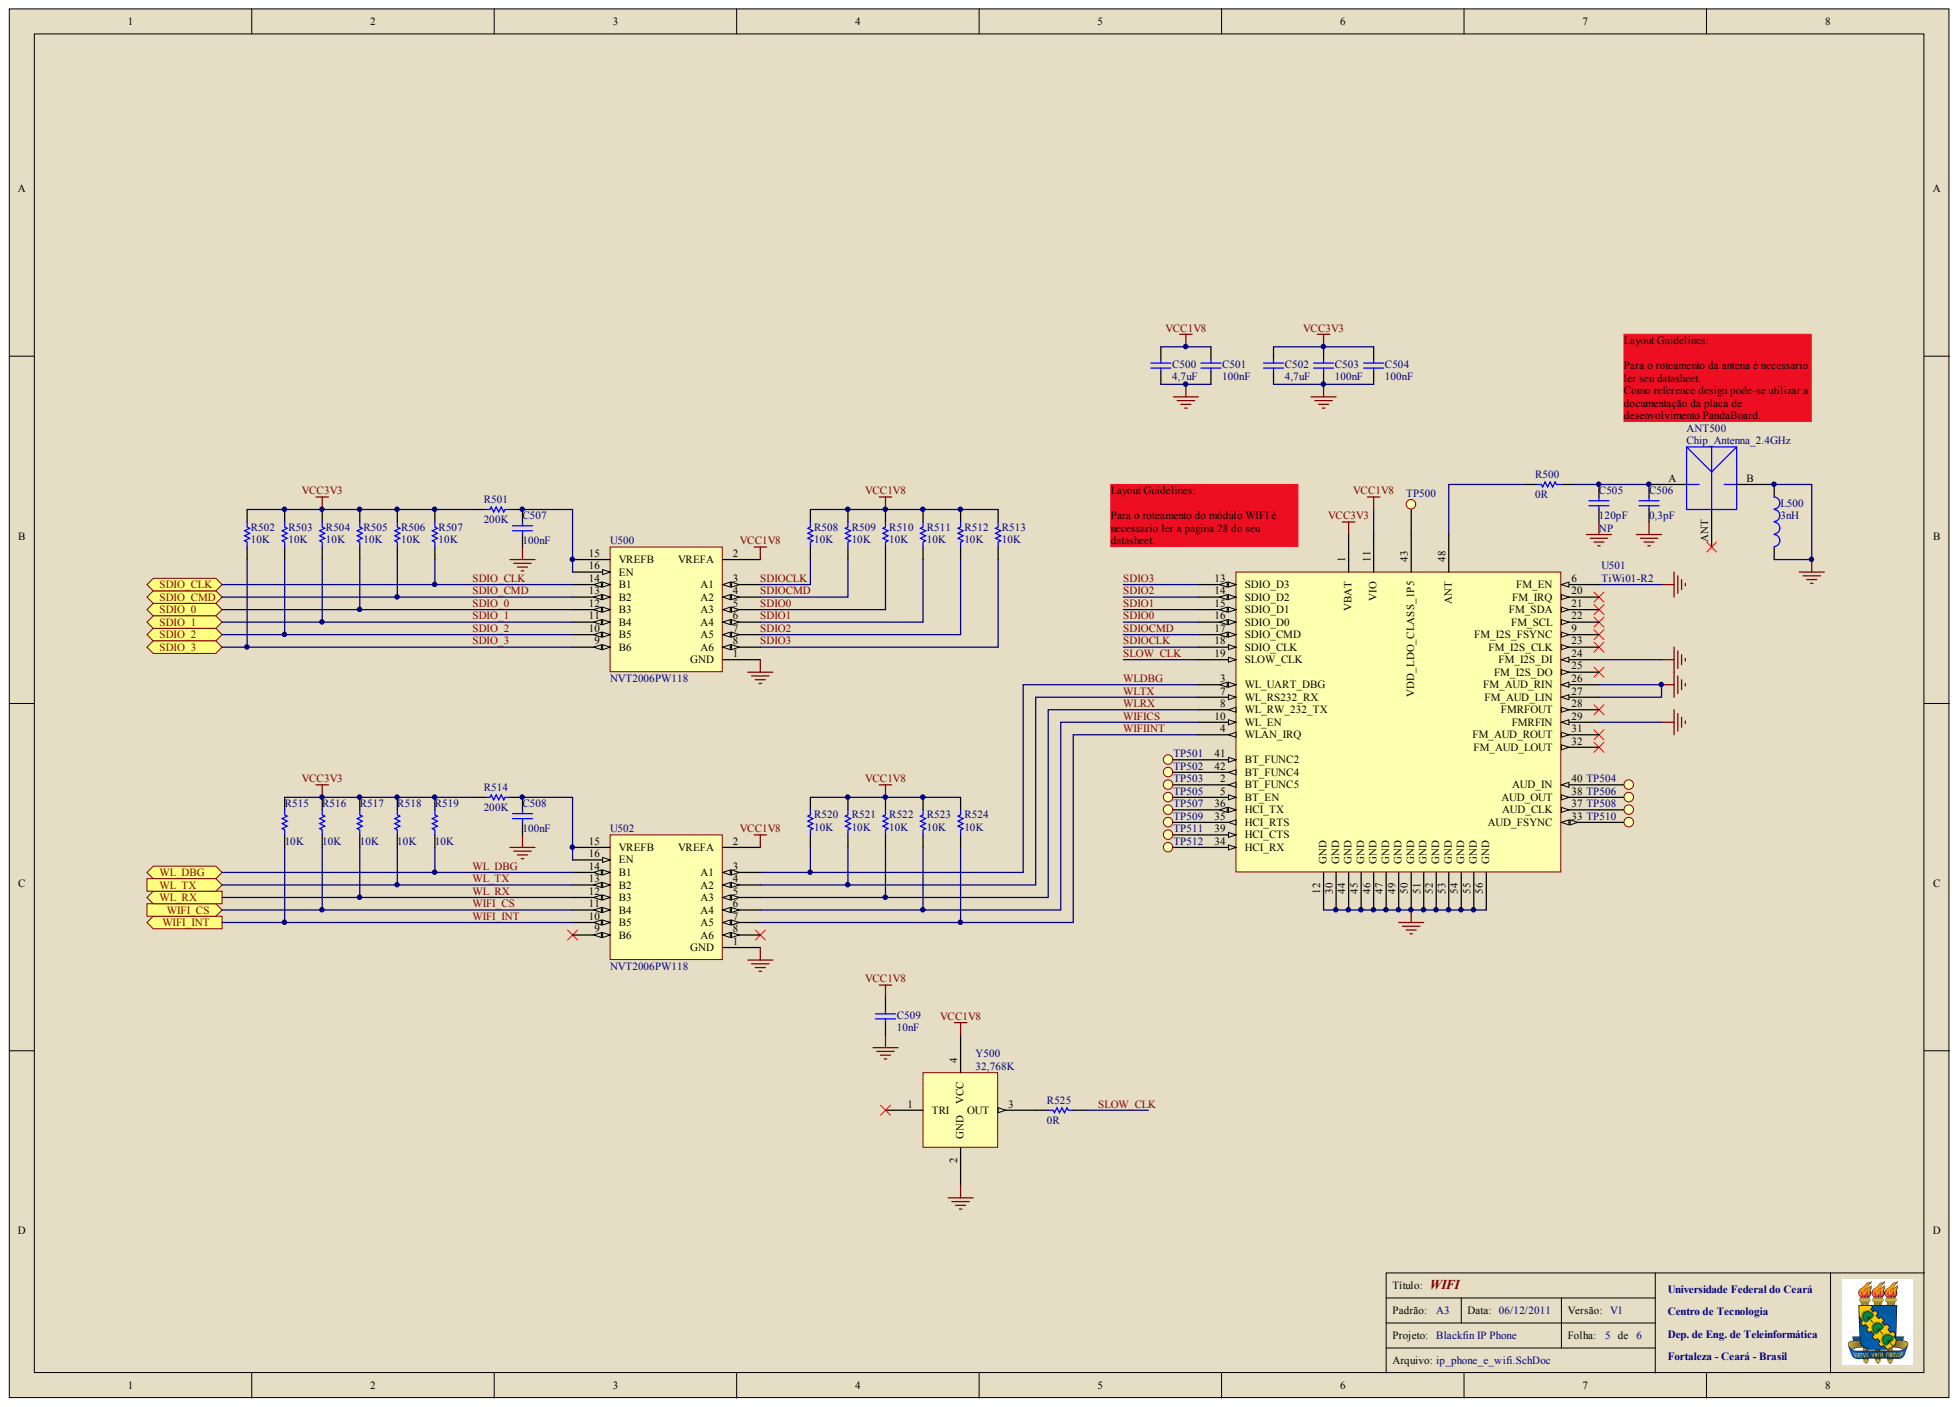
[picture p16: page 5]

Para o roteamento da antena é necessario
ler seu datasheet.
Como reference design pode-se utilizar a
documentação da placa de
desenvolvimento PandaBoard.

Para o roteamento do módulo WIFI é
necessario ler a pagina 28 do seu
datasheet.

WLTX | WL_RS232_RX 7
WLRX | WL_RW_232_TX 8

WIFIINT | WLAN_IRQ 4

TP501 TP502 TP503 TP505 TP507 R524 TP509 10K TP511 TP512 | BT_FUNC2 41 BT_FUNC4 42 BT_FUNC5 2 BT_EN 5 HCI_CTS 39 HCI_RX 34

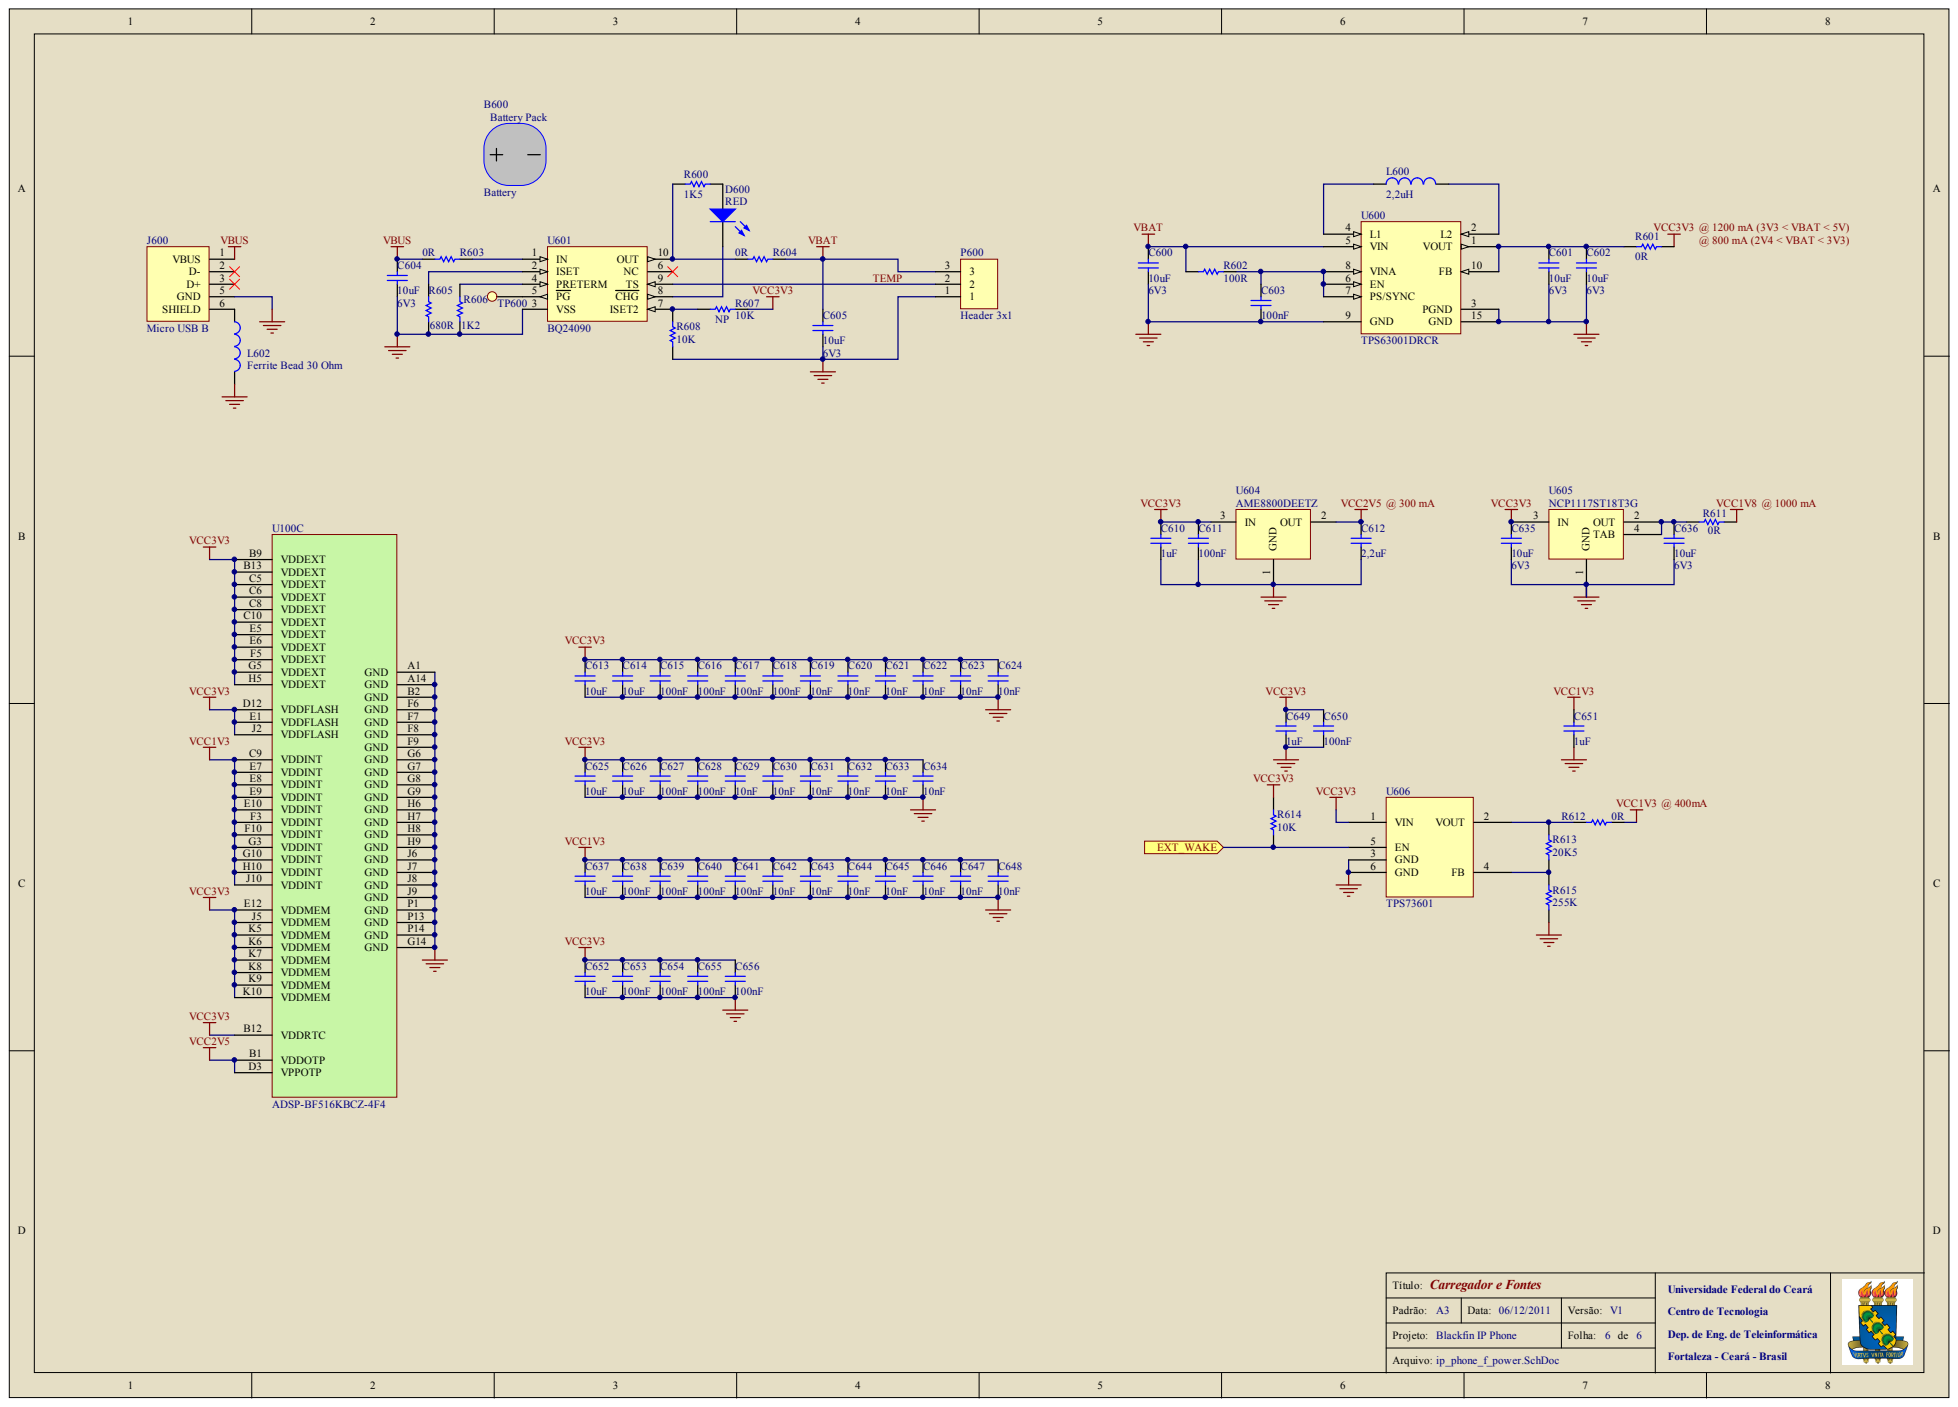
[picture p17: page 6]
