julioamerico/blackfin-ip-phone/(list of files, drawings)

Other design files:
implementacao/extras/pcb/ethernet_ipphone_pcb.PcbDoc
implementacao/extras/prj/ethernet_ipphone_prj.PrjPcb
implementacao/extras/sch/ethernet_ipphone_sch.SchDoc
implementacao/hw/pcb/ip_phone_pcb.PcbDoc
implementacao/hw/prj/ip_phone.PrjPcb
implementacao/hw/sch/ip_phone_a_sdram.SchDoc
implementacao/hw/sch/ip_phone_b_miscellaneous.SchDoc
implementacao/hw/sch/ip_phone_c_codec.SchDoc
implementacao/hw/sch/ip_phone_codec.SchDoc
implementacao/hw/sch/ip_phone_d_lcd_keyboard.SchDoc
implementacao/hw/sch/ip_phone_e_wifi.SchDoc
implementacao/hw/sch/ip_phone_f_power.SchDoc
implementacao/hw/sch/ip_phone_g_codec.SchDoc
