julioamerico/blackfin-ip-phone/(commit log)

2011-07-06 Inseridos os templates de BOM e SCH.
2011-07-18 Criado o projeto.
    [ip_phone.PrjPcb]
2011-07-18 Associadas as bibliotecas ao projeto.
    [ip_phone.PrjPcb]
2011-07-20 inclusao dos footprints da memoria flash, dos resistores, dos capacitores, dos indutores e do processador.
2011-07-20 inclusao das simbologias da memoria flash, dos resistores, dos capacitores, dos indutores e do processador.
2011-07-27 inclusao do footprint do VFBGA54 da SDRAM
2011-08-12 Criado o footprint do codec
2011-08-17 inclusao do footprint CR0402_NP e CR0603_NP na simbologia do resistor
2011-08-17 inclusao dos footprints CR0402_NP e CR0603_NP
2011-08-17 inclusao do arquivo
    [ip_phone_a_sdram.SchDoc]
2011-08-17 inclusao dos esquematicos no projeto
    [ip_phone.PrjPcb]
2011-08-19 inclusao da simbologia do conector de 10 pinos
2011-08-19 inclusao do footprint do conector de 10 pinos
2011-08-22 - Alterada disposição dos pinos do bf518-A - Adicionada simbologia do test point - Adicionada simbologia do ci supervisor (cat811) - Adicionada simbologia do cristal de 32.768KHz - Adicionada simbolo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
2011-08-22 - Adicionado footprint do test point - Adicionado footprint do ci supervisor (cat811) - Adicionado footprint do cristal de 32.768KHz - Adicionado footprint do oscilador de 25MHz
2011-08-22 Iniciado esquemático da sdram
    [ip_phone_a_sdram.SchDoc]
2011-08-22 inclusao do footprint SOIC8
2011-08-22 Adicionado o footprint do push-buttom
2011-08-22 inclusao de parametros no switch
2011-08-22 finalizaçao do esquematico. faltando revisao
    [ip_phone_b_miscellaneous.SchDoc]
2011-08-26 mudança dos sinais do conector que vai para a placa da ethernet
    [ip_phone_b_miscellaneous.SchDoc]
2011-08-26 inclusao dos footprints MSOP, led 0603 e Micro USB
2011-08-26 inclusao das simbologias do led, do carregador e do micro USB.
2011-08-28 atualizado esquemático da sdram
    [ip_phone_a_sdram.SchDoc]
2011-08-28 atualizado esquemático do codec
    [ip_phone_c_codec.SchDoc]
2011-08-29 inclusao do footprint do conector da bateria
2011-08-29 mudança dos resistores de 10k da mouser para os da digikey.
    [ip_phone_b_miscellaneous.SchDoc]
2011-08-30 inclusao dos footprints dos reguladores de 2V5 e 1V3
2011-08-30 inclusao das simbologias dos reguladores de 5V, 2V5 e 1V3.
2011-08-30 adaptaçao nos parametros dos capacitores de 100nF
    [ip_phone_b_miscellaneous.SchDoc]
2011-08-31 inclusao do footprint do modulo wifi
2011-08-31 alteraçao nos parametros do sheet
    [ip_phone_f_power.SchDoc]
2011-09-02 mudanca de MII para RMII e inclusao dos sinais que vao para o WIFI
    [ip_phone_b_miscellaneous.SchDoc]
2011-09-02 inclusao do modelo 3D do modulo wifi e inclusao do footprint do level translator
2011-09-05 inclusao do footprint do micro SD
2011-09-05 inclusao do circuito do micro SD
    [ip_phone_b_miscellaneous.SchDoc]
2011-09-05 finalizado faltando apenas o footprint da antena.
    [ip_phone_e_wifi.SchDoc]
2011-09-05 elaboração do esquemático
    [ip_phone_a_sdram.SchDoc]
2011-09-06 implementação
    [ip_phone_c_codec.SchDoc]
2011-09-06 adicionada simbologia para conector de audio
2011-09-06 inclusao dos footprints do resistor 1210, do oscilador 32K e do regulador de 1V8
2011-09-06 inclusao das simbologias do oscilador de 32K e do regulador de 1V8
2011-09-06 implementaçao da revisao do romulo
    [ip_phone_b_miscellaneous.SchDoc]
2011-09-06 implementacao do circuito do oscilador de 32K
    [ip_phone_e_wifi.SchDoc]
2011-09-06 implementaçao da fonte de 1V8
    [ip_phone_f_power.SchDoc]
2011-09-09 update from libraries para os models dos capacitores
    [ip_phone_d_lcd_keyboard.SchDoc]
2011-09-09 inclusao do footprint da antena na simbologia da antena
2011-09-09 inclusao do footprint da antena
2011-09-09 concluido. faltando apenas as nets dos sheets feito pelo julio.
    [ip_phone_b_miscellaneous.SchDoc]
2011-09-09 finalizado. faltando revisao.
    [ip_phone_e_wifi.SchDoc]
2011-09-11 Integração com os demais sheets
    [ip_phone_b_miscellaneous.SchDoc]
2011-09-11 Finalizado. Restando Revisão
    [ip_phone_a_sdram.SchDoc]
2011-09-11 Ocultado Comment dos Test Points.
    [ip_phone_e_wifi.SchDoc]
2011-09-11 Finalizado. Não revisado
    [ip_phone_c_codec.SchDoc]
2011-09-12 inclusao do footprint sot 223 - 6P
2011-09-12 inclusao do novo regulador de 1V3
2011-09-12 mudanca do regulador de 1V3
    [ip_phone_f_power.SchDoc]
2011-09-12 revisao e inclusao de nome de nets.
    [ip_phone_d_lcd_keyboard.SchDoc]
2011-09-12 Revisão 1: inclusão dos ports que vão para o codec
    [ip_phone_d_lcd_keyboard.SchDoc]
2011-09-12 Revisão 1: inclusão dos ports para controle das chaves analógicas
    [ip_phone_c_codec.SchDoc]
2011-09-12 Revisão 1: inclusão do port JACK_EN
    [ip_phone_b_miscellaneous.SchDoc]
2011-09-12 exlusao de pasta de expansao
2011-09-12 alteracao nas nets.
    [ip_phone_d_lcd_keyboard.SchDoc]
2011-09-12 Incluído no repositório o reference manual da placa PandaBoard, utilizada como referência para o circuito do módulo WiFi.
2011-09-12 revisao e alteracao de nome de nets.
    [ip_phone_b_miscellaneous.SchDoc]
2011-09-12 mudanca nos parametros do cristal de 32KHz
2011-09-12 alteracao no footprint do crystal de 32KHz
2011-09-13 implementacao da revisao
    [ip_phone_d_lcd_keyboard.SchDoc]
2011-09-13 inclusao do footprint do speaker
2011-09-13 - Os testpoints foram modificados para STANDARD (NO BOM). - Corrigidos parâmetros do módulo WiFi. - Alterados os parâmetros de dois capacitores de 100nF do sheet E. - Alterados os parâmetros de algun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
    [ip_phone_a_sdram.SchDoc, ip_phone_b_miscellaneous.SchDoc, ip_phone_c_codec.SchDoc, ip_phone_d_lcd_keyboard.SchDoc, ip_phone_e_wifi.SchDoc, ip_phone_f_power.SchDoc]
2011-09-15 - Corrigido o designator do módulo WiFi. - Alteradas as especificações dos capacitores de 10nF para que sejam comprados de um único fornecedor. - Resistores de pull-up do I2C colocados no sheet B, pr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
    [ip_phone.PrjPcb, ip_phone_a_sdram.SchDoc, ip_phone_b_miscellaneous.SchDoc, ip_phone_c_codec.SchDoc, ip_phone_e_wifi.SchDoc]
2011-09-16 - Incluídos capacitores na entrada e na saída do regulador da tensão do core. - Excluído o resistor de 0R ligando os pinos EN e IN do regulador da tensão do core. - Excluído o resistor de 0R na saída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
    [ip_phone.PrjPcb, ip_phone_b_miscellaneous.SchDoc, ip_phone_f_power.SchDoc]
2011-09-16 - Inserida nota referente aos resistores que ligam os terras analógico e digital. - Alterado o posicionamento dos designators do flip flop.
    [ip_phone_c_codec.SchDoc]
2011-09-16 Alterada a especificação dos capacitores de 10uF
    [ip_phone_f_power.SchDoc]
2011-09-16 Corrigido o footprint do microfone.
2011-09-16 Corrigida a especificação do microfone.
    [ip_phone_c_codec.SchDoc]
2011-09-16 inclusao da pcb
    [ip_phone.PrjPcb]
2011-09-16 inclusao do arquivo.
    [ip_phone_pcb.PcbDoc]
2011-09-20 Criação do esquemático com a segunda opção de circuito para CODEC
    [ip_phone_g_codec.SchDoc]
2011-09-20 Inclusão do sheet ip_phone_g_codec ao projeto
    [ip_phone.PrjPcb]
2011-09-21 altracao da memoria flash para a S25FL064P0XNFI000
2011-09-21 inclusao do footprint WSON8
2011-09-21 inicio do placement
    [ip_phone_pcb.PcbDoc]
2011-09-21 mudanca de memoria flah para a memoria com o footprint WSON8
    [ip_phone_b_miscellaneous.SchDoc]
2011-09-22 Criação do footprint do capacitor de 220uF e do conector jack
2011-09-22 integrado com o novo sheet do codec
    [ip_phone_d_lcd_keyboard.SchDoc]
2011-09-22 arquivo renomeado
    [ip_phone_codec.SchDoc]
2011-09-22 Remoção do sheet ip_phone_g_codec
    [ip_phone.PrjPcb]
2011-09-22 realizado o annotate dos sheets
    [ip_phone_c_codec.SchDoc, ip_phone_d_lcd_keyboard.SchDoc]
2011-09-22 - Inserido número do sheet do codec. - Alterado especificação de alguns resistores e capacitores de 10K, 100K, 4,7uF, 1uF. - Alterado o tipo dos speakers para MECHANICAL. - Criadas as simbologias do 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
    [ip_phone.PrjPcb, ip_phone.xls, ip_phone_c_codec.SchDoc, ip_phone_d_lcd_keyboard.SchDoc, ip_phone_f_power.SchDoc]
2011-09-23 revisao e ajuste.
    [ip_phone_d_lcd_keyboard.SchDoc]
2011-09-23 remoçao da fonte de 5V.
    [ip_phone_f_power.SchDoc]
2011-09-26 revisao e ajustes dos footprints QFN24 e QFN10.
2011-09-26 revisao e correcao.
    [ip_phone_c_codec.SchDoc]
2011-09-26 Alteração dos valores de resistor do circuito de carga de bateria
    [ip_phone_f_power.SchDoc]
2011-09-27 Inclusão do conector de segurança no sheet do codec
    [ip_phone_c_codec.SchDoc]
2011-09-29 - Corrigido o designator do conector de segurança do codec. - Alterada a epecificação de todos os resistores de 100R. - Ocultado o comentário dos fiduciais. - Inserido no sheet B o flat cable e alter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
    [ip_phone_b_miscellaneous.SchDoc, ip_phone_c_codec.SchDoc, ip_phone_f_power.SchDoc]
2011-09-30 BOM concluida.
    [ip_phone.xls]
2011-09-30 annotate de resistores que estavam com ?
    [ip_phone_c_codec.SchDoc]
2011-09-30 inclusao da bateria no esquematico
    [ip_phone_f_power.SchDoc]
2011-09-30 inclusao do simbolo do ESD
    [ip_phone_b_miscellaneous.SchDoc]
2011-09-30 inclusao da imagem de ESD
    [ip_phone_pcb.PcbDoc]
2011-10-07 ajustena net de 1v8 do modulo
    [ip_phone_e_wifi.SchDoc]
2011-10-07 reanotate no conector de expansao
    [ip_phone_c_codec.SchDoc]
2011-10-10 mudanca de nets da intrrupcao do wifi e do card detect
    [ip_phone_b_miscellaneous.SchDoc]
2011-10-10 mudanca dos resistores de calculo da tensao de 1V3 de 0805 para 0402.
    [ip_phone_f_power.SchDoc]
2011-10-14 mudanca de footprints NP para o normal
    [ip_phone_b_miscellaneous.SchDoc]
2011-10-17 placement - implementação
    [ip_phone_pcb.PcbDoc]
2011-10-17 bom final
    [ip_phone.xls]
2011-10-17 correcao no circuito do teclado
    [ip_phone_d_lcd_keyboard.SchDoc]
2011-10-17 mudanca do conector do phone jack
    [ip_phone_c_codec.SchDoc]
2011-10-18 placement - continuação
    [ip_phone_pcb.PcbDoc]
2011-10-19 Excluido o arquivo ip_phone_cuidados.xls
    [ip_phone_cuidados.xls]
2011-10-19 inclusao de regras de pcb
    [ip_phone.PrjPcb]
2011-10-19 roteamento da sdram
    [ip_phone_pcb.PcbDoc]
2011-10-24 Layout do codec e teclado
    [ip_phone_pcb.PcbDoc]
2011-10-24 finalizaçao da sdram faltando apenas equalizaçao e inicio do miscelaneous.
    [ip_phone_pcb.PcbDoc]
2011-10-26 Layout: - Fonte de 3V3 - Circuito de carga da bateria
    [ip_phone_pcb.PcbDoc]
2011-10-26 roteamento do miscelaneous.
    [ip_phone_pcb.PcbDoc]
2011-10-26 mudança nas nets do I2C
    [ip_phone_c_codec.SchDoc]
2011-10-28 conserto da net TXCLK para REF_CLK
    [ip_phone_b_miscellaneous.SchDoc]
2011-10-28 conclusao do miscelaneous e inicio do wifi
    [ip_phone_pcb.PcbDoc]
2011-10-31 criação do footprint do componente FSA2259
2011-10-31 inclusão do componente FSA2259
    [ip_phone_c_codec.SchDoc]
2011-10-31 alteração do placement e reimplementação do layout do codec
    [ip_phone_pcb.PcbDoc]
2011-10-31 inclusao do novo footprint do conector da bateria.
2011-10-31 roteamento do wifi
    [ip_phone_pcb.PcbDoc]
2011-10-31 mudança pro novo conector da bateria.
    [ip_phone_f_power.SchDoc]
2011-10-31 mudança de nets para melhorar o layout.
    [ip_phone_e_wifi.SchDoc]
2011-11-03 conclusao do split plane e faltando apenas VCC1V8 para o wifi e o GND e a antena tudo isso do sheet do wifi
    [ip_phone_pcb.PcbDoc]
2011-11-03 mudanca no footprint WSON8
2011-11-03 inclusao de regras e ajuste na fonte.
    [ip_phone_pcb.PcbDoc]
2011-11-04 roteamento 90% concluido.
    [ip_phone_pcb.PcbDoc]
2011-11-07 Inclusao de nets DD0 ate DD15 e AA0 ate AA12
    [ip_phone_a_sdram.SchDoc]
2011-11-07 equalizaçao das nets de DD0 a DD15
2011-11-16 retornado para versao 253 para voltar para quando o layout nao estado com as nets de dados equalizadas
2011-11-18 Alteração do footprint do botão Reposicionamento do silk de marcação de pino 1 da memória flash
2011-11-18 atualizada a simbologia do regulador NCP1117
    [ip_phone_f_power.SchDoc]
2011-11-22 atualização do layout com o novo footprint do botão.
2011-11-22 inclusão dos footprints dos leds pth de 3mm
2011-11-22 adicionados novos footprints dos leds a sua simbologia
2011-11-22 atualização dos leds
    [ip_phone_b_miscellaneous.SchDoc]
2011-11-23 inclusao do footprint header 2x1
2011-11-23 inclusao do conector de alimentaçao do backligth
    [ip_phone_d_lcd_keyboard.SchDoc]
2011-11-23 substituição do capacitor de alumínio por capacitor de tantulum
    [ip_phone_c_codec.SchDoc]
2011-11-24 troca do capacitor de aluminio por tantalum
2011-11-24 criacao do capacitor de tantalum
2011-11-24 - Feito o alinhamento dos designators de toda a placa. - Ocultados os designators de elementos gráficos e fiduciais.
2011-11-25 Led da bateria alterado para pth 3mm
    [ip_phone_f_power.SchDoc]
2011-11-25 remoçao das nets do RMII e do conector de alimentação para as placas externas
    [ip_phone_b_miscellaneous.SchDoc]
2011-11-25 inclusao do plated no footprint do conector da USB
2011-11-25 conclusao. faltando apenas reorganizar o led da bateria
2011-12-15 Criada a pasta doc e inserido no repositório o documento de requisitos.
2012-01-19 Relatório de firmware e de acompanhamento (1o semestre) inseridos no repositório.
2012-01-19 Concluída a escrita do relatório de acompanhamento.
2012-01-24 Alterações realizadas sobre o Relatório de Acompanhamento. Excluída a versão parcial com extenão odt e incluida a versão final com extensão docx.
2012-01-24 atulizaçao da bom
    [ip_phone.xls]
2012-04-12 inclusao dos componentes phy ethernet, oscilador de 25Mhz e do conector RJ45
2012-04-12 inclusa dos footprints LQFP48, OSC_25MHz_PHY e RJ45
2012-04-12 inclusao do arquivo e implmentação
    [ethernet_ipphone_sch.SchDoc]
2012-04-16 inclusao da simbologia do capacitor de tantalum
2012-04-16 inclusao do footprint do capacitor de tantalum
2012-04-16 finalizado... faltando revisao
    [ethernet_ipphone_sch.SchDoc]
2012-04-16 feito o update pcb. pronto para fazer o placement
    [ethernet_ipphone_pcb.PcbDoc]
2012-04-19 implementação das revisoes
    [ethernet_ipphone_sch.SchDoc]
2012-04-25 inclusao depois do problema ocorrido
    [ethernet_ipphone_pcb.PcbDoc]
2012-04-26 inclusao do oscilador de 50MHz
    [ethernet_ipphone_sch.SchDoc]
2012-04-26 conclusao do layout
    [ethernet_ipphone_pcb.PcbDoc]
2012-11-30 Escrita do relatório de firmware em andamento.
2012-12-03 Relatório de fw em desenvolvimento.
